maduinos/macroKey/docs/HARDWARE.md

> 만든 사람: maduinos<br>
> 문서 만든 날짜: 2026-08-03<br>
> https://maduinos.blogspot.com/

# macroKey 하드웨어

보드와 무관한 설계입니다. **핀 맵, 배선, 플래싱은 보드마다 다르므로 각 보드 문서에**
있습니다 — [지원 보드 목록](BOARDS.md)에서 고르세요.

전원은 어느 보드든 PC USB 하나뿐이고, 이 문서의 내용은 그 제약에서 나옵니다.

## 전력 예산

USB 2.0 장치는 500 mA를 넘게 쓸 수 없습니다. WS2812B 하나는 흰색 최대에서 채널당 약
20 mA, 즉 **60 mA**를 씁니다.

| 조건 | 전류 | 판정 |
| --- | --- | --- |
| 픽셀 1개 흰색 100% + MCU | 90 mA | 예산의 18%. 안전 |
| 픽셀 1개 단색 25% + MCU (기본값) | 35 mA | 예산의 7%. 넉넉 |

픽셀이 하나뿐이라 전력은 사실상 걱정거리가 아닙니다. 밝기를 100%로 올려도 안전합니다.
`Config.h`의 `MK_LED_MAX_MILLIAMPS`는 100으로 잡혀 있지만 1픽셀이 60 mA를 넘길 수 없어
실제로는 걸리지 않습니다. 그래도 남겨 둔 이유는 나중에 `MK_LED_COUNT`를 올리는 순간
다른 곳을 고치지 않아도 이 한 줄이 바로 안전장치로 동작하기 때문입니다.

DIN 라인의 **330~470 Ω 직렬 저항**과 VCC–GND 사이 **100 µF 전해 커패시터**는 모든 보드에서
같습니다.

> **1000 µF를 쓰지 마세요.** 흔히 보이는 그 값은 긴 스트립에 전용 어댑터를 다는 경우의
> 권장값입니다. 이 프로젝트는 픽셀 1개를 PC USB로만 급전하고, USB 2.0 규격은 장치의 벌크
> 커패시턴스를 10 µF로 제한합니다. 실제 포트는 수백 µF까지 견디지만 큰 용량은 돌입 전류로
> 포트 보호를 걸어 "USB 장치를 인식할 수 없음"이 되는 원인이 됩니다. 픽셀 1개에는 100 µF면
> 충분합니다.

**케이블이 조용한 원인입니다.** 길고 얇은 충전 전용 케이블(28 AWG, 2 m 이상)은 보드 쪽 전압을
4.6 V 근처까지 끌어내려 LED 색이 틀어지거나 MCU가 브라운아웃으로 리셋되게 만듭니다.
1 m 이하 데이터용 케이블을 쓰세요.

## WS2812B와 USB 타이밍

WS2812B는 비트뱅 프로토콜이라 전송 중 인터럽트를 막습니다. 픽셀 하나 갱신은 약 30 µs이고
USB SOF 주기는 1 ms이므로 여유가 충분합니다. 8픽셀 스트립일 때 걱정하던 USB 열거 불안정
문제는 픽셀 1개에서는 발생하지 않습니다. `MK_LED_FPS`(기본 50 Hz)는 그대로 두면 됩니다.

## 픽셀 1개로 무엇을 보여주는가

LED 합성 우선순위(높은 것이 이김):

1. 키/매크로 큐 — 탭 흰색, 빈 슬롯 어두운 빨강, 매크로 완료 초록
2. 매크로 실행 중 — 시안 펄스
3. 호스트 오버레이 — 설정 앱이 녹음 중 칠하는 빨강/분홍 등
4. 기본 씬 — 프로필 바탕색

8픽셀 설계에서 두 가지가 줄어듭니다.

- **키별 위치 표시가 불가능합니다.** 펌웨어는 모든 키의 누름을 이 하나의 픽셀로 모읍니다.
- AgentPet 상시 상태 LED는 없습니다(앱이 상시 실행되지 않음).

스트립으로 바꾸고 싶어지면 `Config.h`의 `MK_LED_COUNT`와 호스트 `config/model.py`의
`LED_COUNT`를 같은 값으로 올리면 됩니다. 팔레트 크기와 전류 제한은 그 값에서 자동으로
따라옵니다. `MK_LED_COUNT`와 `MK_KEY_COUNT`는 보드 속성이 아니라 제품 속성이라 `Config.h`에
있습니다 — 보드를 바꿔도 키패드는 8키 1픽셀입니다.

## 부팅 안전장치

펌웨어는 부팅 후 `MK_BOOT_GRACE_MS`(기본 2000 ms) 동안 HID 입력을 보내지 않습니다.
매크로가 잘못 설정돼 무한히 키를 뿜는 상태가 되면 이 2초가 재플래싱할 유일한 기회입니다.

그 2초 안에 부트로더로 들어가는 방법은 보드마다 다릅니다. **어느 보드든 그 방법을 미리
확인해 두세요** — 잘못된 펌웨어에서 빠져나오는 유일한 길이고, 필요해지는 시점에는 이미
키보드가 폭주하고 있습니다. Pro Micro는 `RST`–`GND` 더블탭, RP2040은 BOOTSEL이고, 각 보드
문서에 적혀 있습니다.

정상적인 첫 설치와 헷갈리지 마세요. 그쪽은 Pro Micro가 손댈 것이 없고 RP2040만 첫 1회
BOOTSEL이 필요합니다([BOARDS.md](BOARDS.md#펌웨어-설치)). 여기 적은 것은 **앱이 말을 걸
상대를 잃었을 때**의 탈출구입니다.

## 저장소

프로필이 사는 곳은 보드 속성입니다. 두 종류가 있고, 차이는 물릴 때까지 보이지 않습니다.

- **메모리 맵드 EEPROM** (AVR) — 읽기가 첫 명령부터 되고 쓰기가 그 자리에서 남습니다.
  `begin()`/`commit()`은 할 일이 없습니다.
- **플래시 에뮬레이션** (RP2040 등) — `begin()`이 채워야 첫 읽기가 유효하고, `commit()`이
  되써야 남습니다. 둘 중 하나를 빠뜨리면 패드가 쓰레기를 읽거나 뽑는 순간 다 잊는데,
  **어디에서도 실패하지 않습니다.**

`Profile`은 오직 `Storage.h`의 네 함수만 부르므로, 이 차이는 보드 헤더의
`MK_STORAGE_FLASH_EMULATED` 한 줄이 전부입니다.
