maduinos/macroKey/docs/PROTOCOL.md

> 만든 사람: maduinos<br>
> 문서 만든 날짜: 2026-08-03<br>
> https://maduinos.blogspot.com/

# macroKey 시리얼 프로토콜 v1

호스트 앱과 펌웨어가 USB CDC 위에서 주고받는 규격입니다. 설계 배경은
[`ARCHITECTURE.md`](ARCHITECTURE.md)를 참고하세요.

## 1. 링크

| 항목 | 값 |
| --- | --- |
| 전송 | USB CDC (ATmega32u4 native USB, `Serial`) |
| 속도 | 115200 8N1 (CDC라 실제 보율은 무시되지만 관례로 맞춥니다) |
| 인코딩 | ASCII |
| 프레이밍 | 한 줄에 메시지 하나, `\n` 종료 (`\r`은 무시) |
| 최대 줄 길이 | 96 바이트 (초과분은 버리고 `ERR code=long` 응답) |
| 프로토콜 버전 | `1` |

HID 입력과 시리얼은 완전히 독립입니다. 시리얼을 아무도 열지 않아도 키패드는 동작합니다.

## 2. 메시지 문법

```
<VERB> [key=value ...]
```

- `VERB`는 대문자, 키는 소문자입니다.
- 값에는 공백이 없습니다. 문자열이 필요하면 base64 또는 hex로 보냅니다.
- 알 수 없는 키는 무시합니다(전방 호환). 알 수 없는 `VERB`는 `ERR code=verb`입니다.
- 요청에 `id=N`(1~65535)을 붙이면 응답에 같은 `id`가 실립니다. 붙이지 않으면 응답도
  `id` 없이 옵니다.

## 3. 장치 → 호스트

### `HELLO` — 장치 소개

부팅 직후 한 번, 그리고 `IDENT` 요청마다 보냅니다.

```
HELLO proto=1 fw=0.9.0 board=promicro keys=8 leds=1 bytes=1024
HELLO proto=1 fw=0.9.0 board=promicro-rp2040 keys=8 leds=1 bytes=65520
HELLO proto=1 fw=0.9.1 board=promicro keys=8 leds=1 bytes=1024 reset=1
```

`reset=1`은 **부팅할 때 저장된 프로필을 읽지 못해 공장 기본값을 덮어썼다**는 뜻입니다.
값이 없으면 아니라는 뜻이며, 이 키를 모르는 구형 호스트는 규칙대로 무시합니다.

이 사실은 원래 부팅 직후 `LOG` 한 줄로만 나갔습니다. 그런데 호스트는 포트를 열고
보드가 안정되기를 기다린 뒤 그동안 도착한 것을 **버리고** `IDENT`를 보냅니다. 부팅에
한 번만 나가는 것은 그래서 아무도 보지 못합니다. `HELLO`는 `IDENT`마다 다시 나가므로,
플래그를 여기에 실어야 패드가 기억을 잃은 사실이 호스트에 도달합니다.

호스트는 `proto`가 자신이 아는 버전보다 크면 연결을 거부하고 사용자에게 앱 업데이트를
안내합니다. 조용히 계속 진행하지 않습니다.

### `EV` — 입력 이벤트

```
EV t=key    k=<0..7> g=<tap|double|hold|holdend> ms=<millis>
EV t=record k=<0..7> g=<tap|double> ms=<millis>
```

- `t=key`는 **알림용**입니다. 장치는 이미 HID를 보냈고, 설정 앱은 로깅에 씁니다.
  앱이 안 듣고 있어도 문제 없습니다.
- `t=host`는 **퇴역**입니다(구형 펌웨어가 보낼 수 있음). 설정 앱은 무시합니다.
- `t=record`는 **키 하나를 3초(`MK_RECORD_HOLD_MS`) 동안 단독으로 눌렀다**는 보고입니다.
  이것이 녹음의 유일한 진입점입니다.

  `g`는 **어느 슬롯을 프로그래밍하는지**입니다. 그냥 홀드하면 `tap`, 직전 릴리즈로부터
  `MK_DOUBLE_TAP_MS` 안에 다시 눌러 홀드하면(= 더블클릭 후 홀드) `double`입니다. 이
  판정은 릴리즈와 다음 프레스 사이의 간격만 보고 하며, 탭 지연(`PH_PENDING_TAP`)과는
  무관합니다 — 그쪽은 *이미 더블 바인딩이 있는 키*에서만 켜지는데, 녹음이 필요한 건
  정확히 더블 슬롯이 비어 있는 키이기 때문입니다. 지연 비용도 없습니다.

  `g`가 없는 구형 펌웨어는 `tap`으로 읽습니다.

  장치는 녹음 상태를 **전혀 갖지 않습니다.** 이 이벤트가 녹음 시작인지 종료인지는 설정
  앱이 정합니다. 양쪽이 상태를 나눠 가지면 재연결 후 서로 다른 모드에 있다고 믿게 되고,
  그건 픽셀은 빨간데 아무것도 캡처되지 않는(혹은 그 반대의) 설명 불가능한 고장이 됩니다.

  이벤트를 보내기 직전 장치는 그 키를 릴리즈까지 억제합니다. 손을 뗄 때 바인딩이 같이
  실행되지 않게 하기 위함입니다 — 키를 *쓰는* 게 아니라 *프로그래밍하는* 중이니까요.

  3초에 이르는 도중 400 ms 지점에서 `g=hold`가 한 번 나갑니다. 그래서 hold 제스처에는
  아무것도 바인딩할 수 없습니다. 앱은 이 이벤트를 시리얼 리더 스레드가 아닌 별도
  워커에서 처리해야 합니다.

### `STATE` — 현재 상태

```
STATE bright=64 ledmode=host hid=1 up=123456
```

### `OK` / `ERR`

```
OK  id=7
ERR id=7 code=<verb|arg|range|crc|long|busy|nomem|unsupported>
```

### `LOG` — 진단

```
LOG lvl=<d|i|w|e> msg=<base64>
```

기본은 꺼져 있고 `DBG on=1`로 켭니다. 정상 동작 중에는 시리얼을 조용하게 유지합니다.

## 4. 호스트 → 장치

### 연결 관리

| 메시지 | 설명 |
| --- | --- |
| `IDENT` | `HELLO`로 응답 |
| `PING` | `OK`로 응답. 링크 확인용 |
| `STATE?` | `STATE`로 응답. `macro=1`이면 매크로 재생 중 |
| `DBG on=<0\|1>` | `LOG` 출력 토글 |

매크로가 재생되는 동안에는 **`PING`·`IDENT`·`STATE?`만 답하고** 나머지 명령은
`ERR busy`로 거절합니다. 매크로는 `loop()` 안에서 EEPROM의 레코드를 읽으며 도는데, 그
도중에 프로필이 커밋되면 발밑에서 스텝이 바뀝니다. 반복 재생은 40분 넘게 이어질 수 있고
앱은 1초마다 링크를 확인하므로, 아무것도 답하지 않으면 그동안 패드가 뽑힌 것으로 보입니다
— 그래서 읽기만 열어 둡니다.

### LED

| 메시지 | 설명 |
| --- | --- |
| `LED mode=<host\|local>` | 앰비언트 계층 소유권. `host`는 3초 워치독이 걸립니다 |
| `LED bright=<0..255>` | 전역 밝기. 전력 상한 스케일링은 이 뒤에 적용됩니다 |
| `LED i=<0..leds-1> rgb=<RRGGBB> [fx=<효과>] [ms=<주기>]` | 픽셀 하나. 지금은 픽셀이 1개라 `i=0`뿐 |
| `LED all rgb=<RRGGBB> [fx=..] [ms=..]` | 전체 동일 색 |
| `LED frame=<RRGGBB,…leds개>` | 전체 프레임 한 번에. 애니메이션은 호스트가 계산 |
| `LED bar=<0..100> rgb=<RRGGBB>` | 진행률 바 (디버그/미리보기용) |

효과: `solid`, `breathe`, `pulse`, `blink`, `flash`, `rainbow`.

`frame=`은 호스트가 모든 픽셀을 직접 그리는 모드이고, `fx=`는 장치가 애니메이션을 돌리는
모드입니다. **효과를 장치에 맡기면 링크가 잠깐 끊겨도 애니메이션이 끊기지 않습니다.**
호스트 CPU를 아끼려면 `fx=`를, 복잡한 그라디언트가 필요하면 `frame=`을 쓰세요.

### 프로필 전송

프로필 블롭(AVR **1,024 B**, RP2040 **65,520 B**)을 base64 청크로 나눠 보냅니다.
`HELLO bytes=`가 해당 장치의 크기이며, 호스트는 다른 크기를 잘라 보내지 않고 거부합니다.
한 줄 96바이트 제한 때문에 청크당 페이로드는 48바이트(base64 64자)입니다.

```
호스트: PROF begin bytes=<HELLO의 bytes> crc=<CRC16 hex>
장치:   OK
호스트: PROF data seq=0 b64=<64자>
장치:   OK
        …  (seq 21까지)
호스트: PROF commit
장치:   OK              # CRC 검증 통과, EEPROM 기록 완료
        ERR code=crc    # 검증 실패, EEPROM은 그대로
```

**CRC가 맞을 때까지 EEPROM을 건드리지 않습니다.** 전송 중 케이블이 빠져도 장치에 남아 있던
프로필은 멀쩡합니다. `PROF begin` 후 5초 안에 `commit`이 없으면 스테이징 버퍼를 버립니다.

읽기는 반대 방향입니다.

```
호스트: PROF read
장치:   PROF begin bytes=<HELLO의 bytes> crc=<hex>
        PROF data seq=0 b64=<…>
        …
        PROF end
```

### 기타

| 메시지 | 설명 |
| --- | --- |
| `SAVE` | 런타임 변경(밝기 등)을 영구 저장소에 반영 |
| `RESET defaults=1` | 공장 초기화 |
| `BOOT` | 부트로더 진입 (펌웨어 업데이트용). 진입 방법이 없는 빌드는 `ERR code=unsupported` |
| `MOUSE home` | 포인터를 화면 좌상단으로 보냅니다. `Fixed screen` 녹화가 캡처 직전에 부릅니다 — 이후 모든 좌표를 그 모서리 기준으로 재므로 재생이 녹화한 자리에 떨어집니다. 부팅 유예 중이면 `ERR code=busy` |

## 5. 연결 수립 절차

호스트가 지켜야 하는 순서입니다.

1. 후보 시리얼 포트를 찾습니다 (VID/PID 또는 사용자 지정).
2. 포트를 열고 **2초 대기**합니다. Leonardo는 포트 열 때 리셋될 수 있습니다.
3. `IDENT`를 보내고 2초 안에 `HELLO`를 기다립니다. 없으면 다음 후보로 넘어갑니다.
4. `proto` 버전을 확인합니다.
5. `PROF read`로 장치 프로필을 읽어 로컬 프로필과 비교합니다. 다르면 사용자에게
   어느 쪽을 기준으로 할지 묻습니다. **말없이 덮어쓰지 않습니다.**
6. 녹음/미리보기 중에만 `LED mode=host`로 짧은 오버레이를 잡습니다. 평소에는
   앱을 종료해도 됩니다 — 패드는 HID로 혼자 동작합니다.

연결이 끊기면 지수 백오프(1s → 2s → 4s → 최대 30s)로 3번 절차부터 재시도합니다.
**한 번이라도 맺어졌던 링크에 한해서**입니다. 앱을 켤 때 패드가 없었던 경우까지 타이머로
계속 재시도하면 무관한 시리얼 장치의 포트를 반복해서 여는 셈이 되고, 포트를 여는 것만으로
리셋되는 보드가 흔합니다. 사용자가 직접 Disconnect한 경우도 재시도하지 않습니다.

## 6. 버전 정책

- 필드 **추가**는 마이너 변경입니다. 수신자는 모르는 키를 무시해야 합니다.
- 필드 **삭제**나 의미 변경, `VERB` 삭제는 `proto` 증가입니다.
- 장치는 자신이 아는 유일한 버전만 말합니다. 호환 계층을 장치에 넣지 않습니다.
  2 KB SRAM은 하위 호환 코드를 둘 자리가 아니고, 그 일은 호스트가 합니다.
