maduinos/macroKey/CLA.md

> 만든 사람: maduinos<br>
> 문서 만든 날짜: 2026-09-13<br>
> https://maduinos.blogspot.com/

# Contributor License Agreement

macroKey에 코드·문서·그 밖의 자료를 보내려면 이 문서에 한 번 동의해야 합니다.
PR을 열면 봇이 서명 방법을 알려 주고, 한 번 서명하면 이후 PR에는 다시 묻지 않습니다.

## 왜 필요한가

**기여한 코드의 저작권은 기여자에게 있습니다.** 그래서 프로젝트 소유자라도 그 코드를
현재 라이선스가 아닌 조건으로는 쓸 수 없습니다. macroKey는 하드웨어와 함께 판매될
예정이고, 나중에 라이선스를 바꾸거나 상업 라이선스를 따로 제공해야 할 수 있습니다.
기여자가 한 명이라도 그 권한을 주지 않았으면 그때 가서는 불가능합니다 — **소급해서
받을 수 없기 때문에** 지금 걸어 둡니다.

이 문서는 **저작권 양도가 아닙니다.** 기여자는 자기 코드의 저작권을 그대로 갖고,
아래 범위의 사용 허락만 추가로 줍니다.

---

## 동의 내용

이 저장소에 기여물(Contribution)을 제출함으로써 기여자는 다음에 동의합니다.

1. **저작권 라이선스.** 기여자는 maduinos에게 기여물을 복제·수정·2차적저작물 작성·
   공중송신·배포·재실시허락할 수 있는, **기간과 지역의 제한이 없고, 비독점적이며,
   무상이고, 취소할 수 없는** 라이선스를 부여합니다. 여기에는 **현재 저장소의
   라이선스가 아닌 조건 — 상업용·비공개 조건을 포함하여 — 으로 배포하는 것**이
   포함됩니다.

2. **특허 라이선스.** 기여물 자체 또는 기여물과 이 프로젝트의 결합에 의해 필연적으로
   침해되는, 기여자가 보유하거나 통제하는 특허청구항에 대하여, 위와 같은 범위의
   무상·취소불가 라이선스를 부여합니다.

3. **권리 보유의 진술.** 기여자는 기여물이 자신의 창작물이며 이 문서에 따른 라이선스를
   부여할 권한이 있음을 진술합니다. 기여물의 전부 또는 일부가 **고용주에게 귀속되는
   경우, 기여자는 고용주로부터 허락을 받았거나 고용주가 그 부분에 대한 권리를
   포기하였음**을 진술합니다.

4. **제3자 저작물.** 기여자가 자신의 창작물이 아닌 부분을 포함시키는 경우, 그 출처와
   라이선스를 기여물 안에 명시해야 합니다.

5. **저작권 유지.** 기여자는 기여물에 대한 자신의 저작권을 그대로 보유하며, 기여물을
   다른 곳에 다른 조건으로 사용·배포할 자유도 그대로 유지합니다.

6. **채택 의무 없음.** maduinos는 기여물을 반드시 반영할 의무가 없습니다.

7. **보증 없음.** 기여물은 있는 그대로 제공되며, 기여자는 관련 법이 요구하지 않는 한
   어떠한 보증도 하지 않습니다.

---

## English

By submitting a Contribution to this repository, you agree that:

1. **Copyright licence.** You grant maduinos a perpetual, worldwide, non-exclusive,
   royalty-free, irrevocable licence to reproduce, modify, prepare derivative works
   of, publicly display, sublicense and distribute your Contribution, **including
   under licence terms other than those of this repository at the time of the
   Contribution — commercial and proprietary terms included**.
2. **Patent licence.** You grant a licence of the same scope under any patent claims
   you own or control that are necessarily infringed by your Contribution alone or
   by its combination with this project.
3. **Right to grant.** The Contribution is your original work and you are legally
   entitled to grant the above. If any part of it belongs to your employer, you have
   their permission, or they have waived their rights in that part.
4. **Third-party material.** Anything in the Contribution that is not your own work
   is identified as such, with its source and licence, inside the Contribution.
5. **You keep your copyright.** This is a licence, not an assignment. You remain free
   to use and distribute your Contribution elsewhere on any terms you like.
6. **No obligation to use.** maduinos is under no obligation to merge or ship it.
7. **No warranty.** Contributions are provided as-is, without warranty of any kind
   except as required by applicable law.

The Korean text above and this English text describe the same agreement. If they
conflict, the Korean text governs.

---

## 서명하는 법

PR을 열면 봇이 댓글로 안내합니다. 그 PR에 아래 문장을 **그대로** 댓글로 남기면
서명됩니다.

```
I have read the CLA Document and I hereby sign the CLA
```

서명 기록은 이 저장소의 `cla-signatures` 브랜치에 남습니다. 문서가 개정되면 다시
서명을 요청합니다.

이 문서는 법률 자문이 아닙니다. 문의: https://maduinos.blogspot.com/
