maduinos/macroKey/tools/pyinstaller_hooks/README.md

> 만든 사람: maduinos<br>
> 문서 만든 날짜: 2026-08-12<br>
> https://maduinos.blogspot.com/

# Optional PyInstaller hooks (picked up by build_release.sh when present).
