maduinos/macroKey/firmware/firmware.ino

// macroKey firmware -- Arduino Leonardo / Micro / Pro Micro.
//
// Eight GPIO buttons and a WS2812 pixel presented as a USB HID keyboard and
// mouse. The pad is fully usable with no software installed; the desktop app
// is only for configuration and recording.
//
// docs/ARCHITECTURE.md  design and rationale
// docs/PROTOCOL.md      serial wire format
// docs/HARDWARE.md      pinout and power budget

#include "src/ButtonInput.h"
#include "src/Config.h"
#include "src/KeyEngine.h"
#include "src/LedController.h"
#include "src/Profile.h"
#include "src/SerialProtocol.h"

// Overrides the core's weak default so the HID endpoint is polled as often as
// the board allows. It has to be a definition in the sketch, not a header: the
// linker picks it over the weak one, and a header included twice would be two
// definitions of the same symbol.
#if defined(MK_HID_POLL_INTERVAL_IS_OVERRIDABLE)
int usb_hid_poll_interval = MK_HID_POLL_INTERVAL_MS;
#endif

static Profile gProfile;
static ButtonInput gInput;
static LedController gLeds;
static KeyEngine gEngine;
static SerialProtocol gSerial;

static uint32_t gLastScanAt = 0;

// RX and TX sit on PB0 and PD5, wired from VCC through a resistor down to the
// pin, so the pin lights them by sinking current. USB_Send() turns them on for
// 100 ms on every transfer -- HID reports included, which is why a keypress
// blinks them -- and it does so from the USB interrupt, where nothing can be
// hooked. Driving them off again just races that ISR and still leaves a flicker.
//
// Making the pins inputs with the pull-up off removes the sink entirely: there
// is no path for current, so the core can write the port all it likes and the
// LEDs cannot light. It has to run every pass rather than once in setup()
// because a USB reset re-runs TX_RX_LED_INIT and makes them outputs again.
#if MK_QUIET_BOARD_LEDS && defined(RXLED0) && defined(TXLED0)
static inline void quietBoardLeds() {
  DDRB &= (uint8_t) ~(1 << 0);
  PORTB &= (uint8_t) ~(1 << 0);
  DDRD &= (uint8_t) ~(1 << 5);
  PORTD &= (uint8_t) ~(1 << 5);
}
#else
static inline void quietBoardLeds() {}
#endif

// KeyEngine reports through plain function pointers so it carries no dependency
// on the serial layer. These trampolines are the only place the two meet.
static void reportKey(uint8_t key, uint8_t gesture, bool released) {
  gSerial.sendKeyEvent(key, gesture, released);
}

static void reportRecordRequest(uint8_t key, uint8_t gesture) {
  gSerial.sendRecordRequest(key, gesture);
}

// Called from inside a replaying macro, which blocks loop(). The engine
// services the button scanner itself; this is the lights and the link.
//
// Serial used to be left queued here, because a profile committed mid-macro
// would change the steps out from under it. A looped macro made that too
// expensive: 255 passes can run for the better part of an hour and the app
// polls the link every second, so the pad read as unplugged for the whole
// loop. SerialProtocol refuses anything that writes while a macro is on the
// stack instead, which keeps that guarantee and still answers a status query.
static void macroYield() {
  quietBoardLeds();
  gSerial.update(millis());
  gLeds.update(millis());
}

void setup() {
  quietBoardLeds();
  gInput.begin();

  bool profileValid = gProfile.begin();
  gLeds.begin(&gProfile);
  gEngine.begin(&gProfile, &gInput, &gLeds);
  gEngine.setReportCallback(reportKey);
  gEngine.setRecordCallback(reportRecordRequest);
  gEngine.setMacroYield(macroYield);
  gSerial.begin(&gProfile, &gEngine, &gLeds);
  // Latched, not just logged: the LOG below lands in the window the host
  // flushes on connect, so without this the pad losing its profile is silent.
  gSerial.setProfileReset(!profileValid);

  // Announce ourselves unconditionally: a host that opens the port later will
  // send IDENT, and one that was already listening gets the greeting for free.
  gSerial.sendHello();
  if (!profileValid) gSerial.sendLog('w', "profile reset to defaults");
}

void loop() {
  uint32_t now = millis();

  quietBoardLeds();

  if (now - gLastScanAt >= MK_SCAN_INTERVAL_MS) {
    gLastScanAt = now;
    gInput.update(now);
    gEngine.update(now);
  }

  gSerial.update(now);

  // LEDs go last. The WS2812 bit-bang blocks interrupts, so it stays off the
  // path between a key press and its HID report.
  gLeds.update(now);
}
