maduinos/macroKey/macrokey/app.py

"""Wires the pieces together. No UI toolkit is imported from here.

Everything the GUI can do, this class can do headless: connect, sync, record.
The GUI is a view over this object. After configuration the app can quit -- the
pad runs as a USB HID device on its own.
"""

from __future__ import annotations

import logging
import queue
import threading
from collections.abc import Callable
from dataclasses import replace

from .boards import DEFAULT_BOARD, Board, board_by_id, board_by_profile_size
from .config import (
    KEY_COUNT,
    Profile,
    ProfileError,
    Settings,
    binary,
    is_factory_default,
    load_profile,
    save_profile,
)
from .device import (
    DeviceClient,
    DeviceError,
    KeyEvent,
    RecordRequest,
    candidates,
)
from .recorder import Recorder
from .recorder.normalize import compile_device_macro, redact_secrets

log = logging.getLogger(__name__)

StatusCallback = Callable[[str], None]
EventCallback = Callable[[object], None]

#: How long the pad acknowledges a write for. Long enough to catch the eye
#: while looking at the keypad, short enough not to sit there.
CONFIRM_FLASH_MS = 600


class MacroKeyApp:
    def __init__(self, status: StatusCallback | None = None) -> None:
        self.settings = Settings.load()
        self.profile: Profile = load_profile()
        self._status_callbacks: list[StatusCallback] = []
        self._event_callbacks: list[EventCallback] = []
        if status is not None:
            self._status_callbacks.append(status)

        self.device = DeviceClient(
            on_event=self._on_device_event,
            on_status=self.status,
            on_disconnect=self._on_device_disconnect,
            on_connect=self._on_device_connect,
        )
        self.recorder = Recorder(
            min_gap_ms=self.settings.recorder_min_gap_ms,
            capture_mouse=self.settings.recorder_capture_mouse,
            anchor_mouse=self.settings.recorder_anchor_mouse,
            preserve_key_timing=self.settings.recorder_preserve_key_timing,
        )
        #: How many steps the last recording lost to the password filter.
        self.last_redacted = 0
        #: Set by whoever wants to drive hold-to-record; None disables it.
        self.session = None

        # Record requests are handled here, one at a time, and never on the
        # thread that delivered them. See `_record_worker`.
        self._record_queue: queue.Queue[tuple[int, str, bool] | None] = queue.Queue()
        self._record_thread: threading.Thread | None = None
        self._closed = threading.Event()

    # ------------------------------------------------------------ observers --

    def on_status(self, callback: StatusCallback) -> None:
        self._status_callbacks.append(callback)

    def on_event(self, callback: EventCallback) -> None:
        self._event_callbacks.append(callback)

    def status(self, message: str) -> None:
        log.info("%s", message)
        for callback in list(self._status_callbacks):
            try:
                callback(message)
            except Exception:  # noqa: BLE001 - a broken view must not stop the app
                log.exception("status callback raised")

    # ------------------------------------------------------------- lifecycle --

    def connect(self, port: str | None = None) -> None:
        """Opens the keypad, falling back to discovery when a named port is gone.

        The port number changes whenever the board re-enumerates, which happens
        on every firmware upload, so a remembered port goes stale routinely.
        Failing on that instead of looking again would mean the app cannot find
        a device that is plugged in and working.
        """
        closed = getattr(self, "_closed", None)
        if closed is not None and closed.is_set():
            raise DeviceError("application is closed")
        # `None` means "use the remembered choice"; an explicit empty string
        # means Auto. Treating both as falsy made selecting Auto silently reopen
        # the previously pinned port.
        remembered = port is None
        wanted = self.settings.port if remembered else port
        if remembered and wanted and wanted not in {item.device for item in candidates()}:
            self.status(f"{wanted} is gone; looking for the keypad")
            wanted = ""
        self.device.connect(wanted)
        # Closing and a worker finishing IDENT can cross by a few instructions.
        # Never let that late success resurrect a serial link after shutdown.
        if closed is not None and closed.is_set():
            self.device.disconnect()
            raise DeviceError("application closed while connecting")

    def disconnect(self) -> None:
        session = self.session
        try:
            if session is not None and getattr(session, "recording", False):
                session.abort("Keypad disconnected, so the recording was dropped")
        finally:
            # Releasing a recorder backend can fail independently of the serial
            # port. A failed cleanup must not leave the keypad attached while
            # the application reports that it disconnected.
            self.device.disconnect()

    def close(self) -> None:
        if self._closed.is_set():
            return
        self._closed.set()
        session = self.session
        if session is not None and getattr(session, "recording", False):
            try:
                session.abort("Application closed; recording discarded")
            except Exception:  # noqa: BLE001 - shutdown must continue
                log.exception("could not abort recording while closing")
        elif self.recorder.recording:
            self.recorder.stop()
        self.disconnect()
        self._record_queue.put(None)
        thread, self._record_thread = self._record_thread, None
        if thread is not None and thread is not threading.current_thread():
            thread.join(timeout=1.0)

    # ---------------------------------------------------------------- events --

    def _on_device_event(self, event: object) -> None:
        if isinstance(event, KeyEvent):
            # Tell the recorder so it drops the keypad's own HID echo.
            self.recorder.note_device_key()
        elif isinstance(event, RecordRequest):
            # A malformed or out-of-sync device must not be able to turn on
            # global input capture. Profile access validates the index again,
            # but recording starts well before a profile is touched.
            if not 0 <= event.key < KEY_COUNT:
                self.status(f"Ignored record request for invalid key {event.key}")
            elif self.session is None:
                self.status(
                    f"Key {event.key + 1} asked to record, but this app is not "
                    "listening — open the editor (macrokey) to program the pad"
                )
                # Distinct from recording-red: the pad asked, nobody answered.
                try:
                    self.device.set_led_mode(True, timeout_ms=900)
                    self.device.set_all((255, 140, 0), effect="flash", period=900)
                except DeviceError:
                    pass
            else:
                # Not inline. This callback *is* the serial reader thread, and
                # handling a record request means talking to the device: setting
                # the LED, then writing the whole profile. Every one of those
                # waits for a reply only the reader thread can deliver -- so
                # running them here means waiting on ourselves.
                self._queue_record_request(event.key, event.gesture)

        for callback in list(self._event_callbacks):
            try:
                callback(event)
            except Exception:  # noqa: BLE001
                log.exception("event callback raised")

    def _on_device_disconnect(self, reason: str) -> None:
        """Stops global capture immediately when the only stop control vanishes."""
        session = self.session
        if session is not None and getattr(session, "recording", False):
            try:
                session.abort("Keypad disconnected, so the recording was dropped")
            except Exception:  # noqa: BLE001 - preserve the original link failure
                log.exception("could not abort recording after disconnect")

    def request_record(
        self, key: int, gesture: str = "tap", *, finish_only: bool = False
    ) -> None:
        """Asks the session to start or finish recording into `key`.

        Public because the session's own watchdog needs it: a recording that has
        run too long has to be finished, and that must happen on the worker like
        every other request rather than on whatever thread noticed.
        """
        self._queue_record_request(key, gesture, finish_only=finish_only)

    def _queue_record_request(
        self, key: int, gesture: str = "tap", *, finish_only: bool = False
    ) -> None:
        """Hands a record request to the worker, starting it on first use."""
        closed = getattr(self, "_closed", None)
        if closed is not None and closed.is_set():
            return
        if self._record_thread is None or not self._record_thread.is_alive():
            self._record_thread = threading.Thread(
                target=self._record_worker, name="macrokey-record", daemon=True
            )
            self._record_thread.start()
        self._record_queue.put((key, gesture, finish_only))

    def _record_worker(self) -> None:
        """Runs record requests in order, off the reader thread.

        One thread rather than one per request: start and finish are two halves
        of the same state machine, and handling them concurrently would let a
        finish overtake the start it belongs to.
        """
        while True:
            request = self._record_queue.get()
            if request is None:
                return
            key, gesture, finish_only = request
            closed = getattr(self, "_closed", None)
            if closed is not None and closed.is_set():
                continue
            session = self.session
            if session is None:
                continue
            if finish_only and (
                not getattr(session, "recording", False)
                or getattr(session, "active_key", None) != key
            ):
                # A watchdog timeout queued a finish, but disconnect/cancel won
                # the race. Treating the stale toggle as a fresh start would
                # briefly turn global capture back on with no keypad attached.
                continue
            try:
                session.handle_request(key, gesture)
            except Exception:  # noqa: BLE001 - a bad recording must not end the thread
                log.exception("record request for key %d failed", key + 1)
                self.status(f"Key {key + 1}: recording failed, see the log")

    # --------------------------------------------------------------- profile --

    @property
    def board(self) -> Board:
        """Which board the profile is being shaped for, connected or not.

        A live HELLO is the truth. Without one the last board seen is a far
        better guess than the registry default, because the alternative is to
        assume the smallest board on the list: that reports an RP2040's fill
        against a 308 record ceiling instead of 21801, and refuses recordings
        the pad has ample room for. It is only ever wrong across a board swap
        made while the app is closed, and the next connect corrects it.
        """
        hello = self.device.hello
        if hello is not None:
            found = board_by_id(hello.board) or board_by_profile_size(hello.profile_bytes)
            if found is not None:
                return found
        remembered = board_by_id(self.settings.last_board)
        return remembered if remembered is not None else DEFAULT_BOARD

    @property
    def profile_layout(self) -> binary.ProfileLayout:
        hello = self.device.hello
        # A connected pad states its own blob size; trust that over the board
        # table in case a firmware ships a size the registry has not caught up
        # with. Disconnected, the remembered board is all there is.
        if hello is not None and hello.profile_bytes in binary.SUPPORTED_PROFILE_SIZES:
            return binary.layout_for_size(hello.profile_bytes)
        return binary.layout_for_board(self.board)

    def _on_device_connect(self, hello) -> None:
        """Persists the connected board so the next cold start knows its size.

        Driven by the device client rather than by `connect` above: the CLI
        opens the pad through `app.device.connect` directly, and hanging this
        off one caller meant `macrokey info` talked to an RP2040 and the app
        still came back assuming the smallest board.
        """
        found = board_by_id(hello.board) or board_by_profile_size(hello.profile_bytes)
        if found is None or found.id == self.settings.last_board:
            return
        self.settings.last_board = found.id
        try:
            self.settings.save()
        except OSError:  # noqa: BLE001 - a read-only config dir must not fail a connect
            log.exception("could not remember the connected board")

    def save(self) -> None:
        save_profile(self.profile)
        self.status("Profile saved")

    def push_profile(self) -> None:
        """Writes the host profile to the device, then says so on the pad."""
        blob = binary.encode_profile(self.profile, profile_size=self.profile_layout.size)
        self.device.write_profile(blob)
        self.confirm_on_device()

    def confirm_on_device(self, color: tuple[int, int, int] = (0, 255, 60)) -> None:
        """Flashes the pixel to acknowledge a write.

        A message in a status bar is in the wrong place: the thing that changed
        is the keypad, and that is where the person is looking after pressing
        Write. Failing to flash is not a failure of the write, so it is swallowed.
        """
        try:
            # A short window, so a crash between here and the release cannot
            # leave the pad stuck on the confirmation colour.
            self.device.set_led_mode(True, timeout_ms=CONFIRM_FLASH_MS)
            self.device.set_all(color, effect="flash", period=CONFIRM_FLASH_MS)
        except DeviceError:
            pass

    def pull_profile(self) -> Profile:
        """Reads the device profile without adopting it."""
        return binary.decode_profile(self.device.read_profile())

    def device_matches_host(self) -> bool:
        """True when device and host hold the same profile bytes."""
        return self.compare_with_device()[0]

    def compare_with_device(self) -> tuple[bool, bool]:
        """``(profiles match, the pad is holding nothing)``, from one read.

        Both answers come from the same blob because they are asked together and
        a second read costs a round trip on a link that is already the slow part
        of connecting.

        The second answer is the one that matters: a pad that differs and a pad
        that has *forgotten* look identical to a byte comparison, and only one
        of them must never be copied over a computer that still has the macros.
        """
        try:
            blob = self.device.read_profile()
            matches = blob == binary.encode_profile(
                self.profile, profile_size=self.profile_layout.size
            )
            return matches, is_factory_default(binary.decode_profile(blob))
        except (DeviceError, ValueError):
            return False, False

    # -------------------------------------------------------------- recording --

    def start_recording(self, on_event=None) -> None:
        """`on_event` receives each raw event as it is captured.

        The editor shows them as they arrive: a recording that is capturing
        nothing looks identical to one that is working until it is stopped,
        which on Wayland is a common and confusing way to lose two minutes.
        """
        if self.recorder.recording:
            raise RuntimeError(
                "a recording is already in progress — finish it before starting another"
            )
        self.recorder._on_event = on_event
        self.recorder.start()
        self.status("Recording.")

    def stop_recording(self) -> list[dict]:
        events = self.recorder.stop()
        self.recorder._on_event = None
        steps = self.recorder.steps(events)
        # Before anything can look at it, let alone store it. Capture is
        # global, so a recording running while a sudo prompt was answered
        # holds that password verbatim -- which has already happened once.
        steps, self.last_redacted = redact_secrets(steps)
        if self.last_redacted:
            self.status(
                f"Dropped {self.last_redacted} step(s) that looked like a password"
            )
        self.status(f"Recorded {len(steps)} step(s)")
        return steps

    def _macro_capacity_used(self, *, ignore_slot: int | None = None) -> int:
        from .config.model import macro_records

        total = 0
        for index, existing in enumerate(self.profile.device_macros):
            if ignore_slot is not None and index == ignore_slot:
                continue
            if existing:
                total += macro_records(existing)
        return total

    def _find_macro_slot(
        self, macro: list, *, also_free: int | None = None
    ) -> int | None:
        """Index that can hold `macro`, or None. Does not mutate the profile.

        `also_free` is a slot that will be released when the binding that owns it
        is replaced -- counted as empty for capacity and reuse.
        """
        from .config.model import MACRO_SLOTS, macro_records

        macros = self.profile.device_macros
        needed = macro_records(macro)
        used = self._macro_capacity_used(ignore_slot=also_free)
        layout = getattr(self, "profile_layout", binary.DEFAULT_LAYOUT)
        if used + needed > layout.record_capacity:
            return None

        limit = max(len(macros), MACRO_SLOTS)
        for index in range(limit):
            if also_free is not None and index == also_free:
                return index
            if index >= len(macros) or not macros[index]:
                return index
        if len(macros) < MACRO_SLOTS:
            return len(macros)
        return None

    def set_repeat(self, key: int, gesture: str, repeat: int) -> str:
        """Makes this key's binding replay `repeat` times, wrapping a shortcut.

        A recording already has somewhere to put the count -- the keymap entry
        naming its slot. A shortcut does not: its four bytes are type, modifiers,
        keycode and flags, with nothing spare. So asking a shortcut to repeat
        turns it into a one-shortcut macro, which is what the pad can repeat.

        Going back to once unwraps it again, rather than leaving a slot holding
        a macro that exists only to be run a single time.

        Returns what happened, for the status line. Raises `ProfileError` when
        there is no room for the wrapping.
        """
        from .config.model import (
            MACRO_SLOTS,
            MIN_MACRO_REPEAT,
            Action,
            repeated_shortcut,
            wrap_shortcut,
        )

        current = self.profile.action(key, gesture)
        macros = self.profile.device_macros

        if current.kind == "sequence":
            held = macros[current.slot] if current.slot < len(macros) else []
            shortcut = repeated_shortcut(held)
            # A wrapped shortcut asked to run once is just the shortcut again.
            # Unwrapping returns the slot; `reclaim_storage` then empties it.
            if shortcut is not None and repeat <= MIN_MACRO_REPEAT:
                self.profile.set_action(key, gesture, shortcut)
                self.profile.reclaim_storage()
                return f"{shortcut.describe()}, once"
            self.profile.set_action(key, gesture, replace(current, repeat=repeat))
            return f"repeats {repeat} times"

        if current.kind != "key":
            raise ProfileError("only a shortcut or a recording can be repeated.")
        if repeat <= MIN_MACRO_REPEAT:
            return f"{current.describe()}, once"

        macro = wrap_shortcut(current)
        slot = self._find_macro_slot(macro)
        if slot is None:
            raise ProfileError(
                "the keypad's macro storage is full, and repeating a shortcut "
                "needs a macro slot. Clear a key you no longer use."
            )
        while len(macros) < MACRO_SLOTS:
            macros.append([])
        macros[slot] = macro
        self.profile.set_action(
            key, gesture, Action(kind="sequence", slot=slot, repeat=repeat)
        )
        self.profile.reclaim_storage()
        return f"{current.describe()} repeats {repeat} times"

    def recording_fits(self, steps: list[dict], key: int, gesture: str) -> bool:
        """True when `assign_recording` would succeed without changing the profile."""
        if self.recorder.device_action(steps) is not None:
            return True
        macro = self.recorder.device_macro(
            steps,
            anchor_pointer=getattr(self.recorder, "anchor_mouse", False),
            max_records=self.profile_layout.max_records_per_slot,
        )
        if macro is None:
            return False
        previous = self.profile.action(key, gesture)
        also_free = previous.slot if previous.kind == "sequence" else None
        return self._find_macro_slot(macro, also_free=also_free) is not None

    def assign_recording(
        self, steps: list[dict], key: int, gesture: str, name: str = ""
    ) -> str:
        """Stores a recording on the pad. Raises if it will not fit.

        The existing binding is left untouched until a device placement is known,
        so a rejected recording cannot wipe a working key.
        """
        from .config import Action
        from .config.model import MACRO_SLOTS

        device_action = self.recorder.device_action(steps)
        if device_action is not None:
            self.profile.set_action(key, gesture, device_action)
            freed = self.profile.reclaim_storage()
            if freed:
                log.debug("reclaimed %d macro slot(s)", freed)
            return f"on the keypad: {device_action.describe()}"

        # Not the None-returning wrapper: the two ways this fails ask for
        # different things from the person, and saying "shorten it" to someone
        # whose recording contains one key the pad cannot send sends them off
        # trimming a macro that was never too long.
        macro = compile_device_macro(
            steps,
            anchor_pointer=getattr(self.recorder, "anchor_mouse", False),
            max_records=self.profile_layout.max_records_per_slot,
        )
        previous = self.profile.action(key, gesture)
        also_free = previous.slot if previous.kind == "sequence" else None
        slot = self._find_macro_slot(macro, also_free=also_free)
        if slot is None:
            raise ProfileError(
                "the keypad's macro storage is full. Clear a key you no longer "
                "use, or record this one in shorter pieces."
            )

        macros = self.profile.device_macros
        while len(macros) < MACRO_SLOTS:
            macros.append([])
        while len(macros) <= slot:
            macros.append([])
        if also_free is not None and also_free != slot and also_free < len(macros):
            macros[also_free] = []
        macros[slot] = macro
        self.profile.set_action(key, gesture, Action(kind="sequence", slot=slot))
        freed = self.profile.reclaim_storage()
        if freed:
            log.debug("reclaimed %d macro slot(s)", freed)
        return f"on the keypad: {len(macro)} step macro"
