maduinos/macroKey/tests/test_firmware_agreement.py

"""The firmware and the host must agree about the same bytes, on every board.

`firmware/src/Profile.h` and `macrokey/config/binary.py` each carry their own
copy of the profile layout. Nothing checks them against each other at build time,
and a disagreement does not fail anywhere -- it produces a macro that replays
garbage, on a device with one pixel and no screen.

The layout check walks `macrokey.boards.BOARDS`, building the firmware once per
board with that board's `-D` and comparing what it reports against what the
registry says. A board added to the registry is therefore checked from the
moment it exists, and a board header that disagrees with its own registry entry
fails here rather than on the hardware.

So the firmware is compiled here for the PC, against the stub headers in
`firmware/test/stubs`, and fed bytes the host encoder produced. What the
firmware's own reader makes of them is compared with what went in.

Skipped, not failed, when there is no C++ compiler: this is a cross-language
check, and a machine without one can still run everything else.
"""

from __future__ import annotations

import shutil
import subprocess
import sys
from pathlib import Path

import pytest

from macrokey.boards import BOARDS, DEFAULT_BOARD, Board
from macrokey.config import binary, model
from macrokey.recorder.evdev_source import MOTION_SLICE_SECONDS
from macrokey.recorder.normalize import reduce_to_device_macro

ROOT = Path(__file__).resolve().parent.parent
FIRMWARE = ROOT / "firmware"
HARNESS = FIRMWARE / "test" / "harness.cpp"

COMPILER = shutil.which("g++") or shutil.which("clang++")
pytestmark = pytest.mark.skipif(
    COMPILER is None, reason="no C++ compiler, so the firmware cannot be run here"
)

#: Sources the harness needs. LedEffects comes along because LedController uses
#: it, and SerialProtocol because a command's effect on the device -- not merely
#: its reply -- is the thing worth testing.
SOURCES = ("Profile.cpp", "Util.cpp", "KeyEngine.cpp", "ButtonInput.cpp",
           "LedController.cpp", "LedEffects.cpp", "SerialProtocol.cpp", "Storage.cpp")


@pytest.fixture(scope="session")
def build_harness(tmp_path_factory):
    """Builds the firmware for this machine, once per board.

    The board is forced with its own `-D` rather than inferred, because this
    machine is neither an AVR nor an RP2040 and the header would otherwise have
    nothing to go on. The store is forced memory-mapped for the same reason:
    a flash-emulated board wants LittleFS, which is a core library and not
    something the stubs stand in for. Neither affects the layout, which is what
    this file compares.
    """
    directory = tmp_path_factory.mktemp("firmware")
    built: dict[str, Path] = {}

    def build(board: Board) -> Path:
        if board.id not in built:
            binary_path = directory / f"harness-{board.id}"
            command = [
                COMPILER, "-std=c++11", "-w", "-o", str(binary_path),
                f"-D{board.select_macro}",
                "-DMK_STORAGE_FLASH_EMULATED=0",
                "-I", str(FIRMWARE / "test" / "stubs"),
                "-I", str(FIRMWARE / "src"),
                str(HARNESS),
                *[str(FIRMWARE / "src" / name) for name in SOURCES],
            ]
            result = subprocess.run(command, capture_output=True, text=True)
            if result.returncode != 0:
                pytest.fail(
                    f"the firmware did not build for {board.id}:\n{result.stderr}"
                )
            built[board.id] = binary_path
        return built[board.id]

    return build


@pytest.fixture(scope="session")
def harness(build_harness) -> Path:
    """The default board, for everything that is not about board differences."""
    return build_harness(DEFAULT_BOARD)


def run(harness: Path, *args: str, blob: bytes | None = None) -> list[str]:
    result = subprocess.run(
        [str(harness), *args], input=blob, capture_output=True, timeout=60
    )
    assert result.returncode == 0, result.stderr.decode("utf-8", "replace")
    return result.stdout.decode("ascii", "replace").splitlines()


def fields(lines: list[str]) -> dict[str, int]:
    return {line.split()[0]: int(line.split()[1]) for line in lines if line}


def serial(harness: Path, blob: bytes, *commands: str) -> tuple[dict[str, int], list[str]]:
    """Runs `commands` against the real serial layer on a pad holding `blob`.

    Returns the device state either side of them, and the lines the pad sent
    back. State first because the reply is rarely the interesting part: the
    failures this catches are commands that answered `OK` and left the pad
    holding something stale.
    """
    lines = run(harness, "serial", "".join(f"{line}\n" for line in commands), blob=blob)
    cut = lines.index("--- transcript")
    return fields(lines[:cut]), lines[cut + 1 :]


def profile_transfer(blob: bytes) -> list[str]:
    """The host half of a profile write, as lines."""
    import base64

    crc = binary.blob_crc(blob)
    lines = [f"PROF begin bytes={len(blob)} crc={crc:04X}"]
    for sequence, offset in enumerate(range(0, len(blob), binary.CHUNK_BYTES)):
        payload = base64.b64encode(blob[offset : offset + binary.CHUNK_BYTES]).decode()
        lines.append(f"PROF data seq={sequence} b64={payload}")
    lines.append("PROF commit")
    return lines


# ------------------------------------------------------------------- layout --


@pytest.mark.parametrize("board", BOARDS, ids=[board.id for board in BOARDS])
def test_the_two_layouts_are_the_same_layout(build_harness, board: Board) -> None:
    """The check this whole file exists for, for every board in the registry.

    The regions before the macro index are the same on every board -- header,
    keymap and palette are counts, not storage -- so what actually varies here
    is the index width, the region that is left, and the schema that says which
    of the two an image is.
    """
    layout = binary.layout_for_board(board)
    seen = fields(run(build_harness(board), "layout"))
    assert seen == {
        "keymap_offset": binary.KEYMAP_OFFSET,
        "keymap_size": binary.KEYMAP_SIZE,
        "keymap_gestures": len(binary.KEYMAP_GESTURES),
        "palette_offset": binary.PALETTE_OFFSET,
        "macro_offset": binary.MACRO_OFFSET,
        "macro_index_size": layout.index_size,
        "macro_record_size": binary.RECORD_SIZE,
        "macro_record_capacity": layout.record_capacity,
        "macro_max_records": board.max_records_per_slot,
        # One byte of a keymap entry, so this is a ceiling neither side can
        # raise alone.
        "macro_max_loops": model.MAX_MACRO_REPEAT,
        "macro_slots": model.MACRO_SLOTS,
        "profile_size": board.profile_size,
        "schema": board.schema,
        "text_delay_default": FIRMWARE_TEXT_DELAY_MS,
        # What one move record represents. The firmware replays a move over
        # this long when nothing after it says otherwise, so if the recorder
        # ever slices motion differently the pad would replay every drag at the
        # wrong speed -- and pointer acceleration would turn that into landing
        # somewhere else.
        "move_slice_ms": int(MOTION_SLICE_SECONDS * 1000),
        # How often the host polls the HID endpoint, which is the ceiling on
        # how fast a replayed movement can be sent. arduino-pico defaults it to
        # 10 ms and the sketch overrides the core's weak symbol to get 1; the
        # AVR core is 1 already. At 10 a recorded 50 ms slice of motion took
        # half a second to replay -- the pointer landed in the right place, so
        # nothing failed and the only symptom was that mouse macros felt wrong
        # on that board. A board that cannot manage 1 ms is allowed, but it has
        # to say so, because runMoves divides by this.
        "hid_poll_interval_ms": 1,
    }


#: What the firmware was built with, and what a profile of 0 falls back to.
FIRMWARE_TEXT_DELAY_MS = 5


def test_the_pad_honours_the_typing_speed_from_the_profile(harness) -> None:
    """Replay is faster than the recording was -- consecutive characters merge
    into one run with no timing kept -- so this is the knob for anything that
    has to catch up. It lives on the profile because the pad replays with the
    app closed, and zero means whatever the firmware was built with."""
    profile = sample_profile()

    profile.text_speed_ms = 0
    lines = run(harness, "profile", blob=binary.encode_profile(profile))
    assert f"text_delay {FIRMWARE_TEXT_DELAY_MS}" in lines

    profile.text_speed_ms = 40
    lines = run(harness, "profile", blob=binary.encode_profile(profile))
    assert "text_delay 40" in lines


def test_the_typing_speed_does_not_disturb_the_body(harness) -> None:
    """It lives in a header byte that was reserved and written as zero, which is
    why it needed no schema bump. The CRC covers the body, not the header."""
    slow, quick = sample_profile(), sample_profile()
    slow.text_speed_ms = 200
    assert binary.encode_profile(slow)[16:] == binary.encode_profile(quick)[16:]
    assert run(harness, "profile", blob=binary.encode_profile(slow))[0] == "valid 1"


# ------------------------------------------------------------------ profile --


def sample_profile() -> model.Profile:
    profile = model.default_profile()
    profile.device_macros = [
        reduce_to_device_macro([
            {"type": "text", "params": {"text": "sudo apt update && sudo apt upgrade -y"}},
            {"type": "delay", "params": {"ms": 300}},
            {"type": "hotkey", "params": {"hotkey": "enter"}},
        ]),
        reduce_to_device_macro(
            [
                {"type": "mouse_button", "params": {"button": "left", "mode": "press"}},
                {"type": "mouse_move", "params": {"dx": 300, "dy": -200}},
                {"type": "mouse_button", "params": {"button": "left", "mode": "release"}},
            ],
            anchor_pointer=True,
        ),
    ]
    profile.set_action(0, "tap", model.Action(kind="sequence", slot=0))
    profile.set_action(1, "double", model.Action(kind="sequence", slot=1))
    return profile


def test_the_firmware_accepts_a_profile_the_host_built(harness) -> None:
    """Magic, schema, topology and CRC, checked by the firmware's own code."""
    lines = run(harness, "profile", blob=binary.encode_profile(sample_profile()))
    assert "valid 1" in lines


def test_the_keymap_reads_back_as_it_was_written(harness) -> None:
    profile = sample_profile()
    lines = run(harness, "profile", blob=binary.encode_profile(profile))

    seen = {}
    for line in lines:
        if not line.startswith("key "):
            continue
        _, key, gesture, type_id, a, b = line.split()
        seen[(int(key), gesture)] = (int(type_id), int(a), int(b))

    for key in range(model.KEY_COUNT):
        for gesture in model.GESTURES:
            action = profile.action(key, gesture)
            expected = action.encode()[:3] if not action.is_empty else (0, 0, 0)
            assert seen[(key, gesture)] == expected, f"key {key + 1} {gesture}"


def test_hold_reads_as_empty_because_it_has_no_slot(harness) -> None:
    """It is how recording starts, so it is reported but never stored."""
    lines = run(harness, "profile", blob=binary.encode_profile(sample_profile()))
    holds = [line for line in lines if line.startswith("key ") and " hold " in line]
    assert len(holds) == model.KEY_COUNT
    assert all(line.endswith(" 0 0 0") for line in holds)


def test_the_macro_records_read_back_byte_for_byte(harness) -> None:
    """Where an index and a region that disagreed would show up."""
    profile = sample_profile()
    lines = run(harness, "profile", blob=binary.encode_profile(profile))

    seen = {}
    for line in lines:
        if not line.startswith("macro "):
            continue
        parts = line.split()
        seen[int(parts[1])] = [tuple(int(n) for n in item.split(",")) for item in parts[2:]]

    for slot, macro in enumerate(profile.device_macros):
        expected = [record for action in macro for record in action.records()]
        assert seen[slot] == expected, f"slot {slot}"


# ------------------------------------------------------------------ buttons --


def test_which_slot_a_hold_programs(harness) -> None:
    seen = {line.split()[0]: line.split()[1] for line in run(harness, "buttons")}
    assert seen == {
        "hold": "tap",
        "tap_then_hold": "double",       # double-click, then keep holding
        "tap_pause_hold": "tap",         # too slow to be a pair
        "short_hold": "none",            # 500 ms is not a request
        # Re-recording a double macro goes through the tap-deferral path, which
        # is only armed once the slot is full -- a different branch entirely.
        "tap_then_hold_when_double_is_bound": "double",
        "hold_just_after_boot": "tap",   # releasedAt starts at zero
    }


def test_the_buttons_are_still_scanned_while_a_macro_replays(harness) -> None:
    """A macro blocks loop(). If the scan stops with it, the second press of a
    double-record gesture is timestamped after the macro finishes -- seconds
    past the pair window -- so recording into the double slot was impossible on
    any key that already had a macro to replay.

    Slot 0, because it types and pauses and so lasts long enough for a press to
    debounce. Slot 1 is a drag with no pause in it: over in a few milliseconds,
    which is both too short to register a press and too short to matter.
    """
    lines = run(harness, "replay", "0", blob=binary.encode_profile(sample_profile()))
    assert "scanned-during-replay 1" in lines


# ------------------------------------------------------------------- replay --


# --------------------------------------------------------------------- loops --


def typed_text(lines: list[str]) -> str:
    return "".join(chr(int(line.split()[1])) for line in lines if line.startswith("type "))


SAMPLE_TEXT = "sudo apt update && sudo apt upgrade -y"


def test_the_loop_ceiling_agrees_with_the_host(harness) -> None:
    """One byte in a keymap entry, described in two places."""
    assert fields(run(harness, "layout"))["macro_max_loops"] == model.MAX_MACRO_REPEAT


def test_a_loop_replays_the_macro_once_per_pass(harness) -> None:
    blob = binary.encode_profile(sample_profile())
    lines = run(harness, "replay", "0", "3", blob=blob)
    assert typed_text(lines) == SAMPLE_TEXT * 3


def test_a_binding_with_no_loop_count_runs_once(harness) -> None:
    """Zero is what every profile written before loop counts existed holds.

    It has to mean one pass rather than none, or upgrading the firmware would
    silently stop every macro already on the pad.
    """
    blob = binary.encode_profile(sample_profile())
    assert typed_text(run(harness, "replay", "0", "0", blob=blob)) == SAMPLE_TEXT


def test_each_pass_lets_go_of_what_it_was_holding(harness) -> None:
    """A recording may end mid-hold -- a press with no release is half a hold,
    and the normaliser keeps it. Looping that would press an already-pressed key
    and then leave it down when the loop stopped.
    """
    blob = binary.encode_profile(sample_profile())
    lines = run(harness, "replay", "1", "3", blob=blob)
    assert lines.count("key release-all") == 3


def test_a_key_pressed_during_a_loop_stops_it(harness) -> None:
    """The reason a ceiling of 255 is safe to offer at all: 255 passes of a
    recording with real hold timing in it is most of an hour, and the pad is a
    keyboard the whole time.
    """
    blob = binary.encode_profile(sample_profile())
    passes = typed_text(run(harness, "replay", "0", "20", "300", blob=blob))
    assert len(passes) < len(SAMPLE_TEXT) * 20, "the press did not stop the loop"


def test_the_key_that_stops_a_loop_does_not_also_fire(harness) -> None:
    """Stopping a macro is not using the key. Without the swallow, letting go
    of it fires its tap -- so stopping one macro starts another.
    """
    blob = binary.encode_profile(sample_profile())
    lines = run(harness, "replay", "0", "20", "300", blob=blob)
    assert "stop-key-suppressed 1" in lines


def test_a_key_held_before_the_loop_started_does_not_stop_it(harness) -> None:
    """The key the macro is running *for* is normally up by the time it runs --
    tap and double both fire on release -- but the scan is alive through a macro
    and the harness holds key 1 down throughout. Counting what was already held
    would stop every loop in its first pass.
    """
    blob = binary.encode_profile(sample_profile())
    assert typed_text(run(harness, "replay", "0", "2", blob=blob)) == SAMPLE_TEXT * 2


def test_a_press_inside_the_arming_window_does_not_stop_a_macro(harness) -> None:
    """A press this early is someone pressing the key again, not stopping it: it
    queues and fires afterwards, the way an ordinary macro has always behaved. A
    short macro that a second press killed would be one nobody could press twice
    in a row.
    """
    blob = binary.encode_profile(sample_profile())
    lines = run(harness, "replay", "0", "1", "300", blob=blob)
    assert typed_text(lines) == SAMPLE_TEXT
    assert "stop-key-suppressed 0" in lines


def test_a_long_single_pass_macro_can_still_be_stopped(harness) -> None:
    """The pass count is the wrong thing to gate stopping on, and this is the
    recording that proved it: 39 s of real hold timing bound to a key at one
    repeat could not be stopped by anything short of the cable. Arming on how
    long the run has lasted covers a loop and a long recording both.
    """
    profile = model.default_profile()
    profile.device_macros = [
        [
            model.Action(kind="delay", delay_ms=12000),
            model.Action(kind="key", hotkey="esc"),
        ]
    ]
    lines = run(harness, "replay", "0", "1", "2000", blob=binary.encode_profile(profile))
    # KEY_ESC is 0xB1 = 177 in Keyboard.h. The macro never reaches it.
    assert "key press 177" not in lines, "the press did not stop the macro"
    assert "stop-key-suppressed 1" in lines


def test_a_status_query_is_answered_from_inside_a_macro(harness) -> None:
    """Why serial is pumped from the macro yield at all. The app polls the link
    every second; a loop that answered nothing would read as an unplugged pad
    for as long as it ran.
    """
    blob = binary.encode_profile(sample_profile())
    lines = run(harness, "macro-serial", "0", "STATE?\n", blob=blob)
    state = next(line for line in lines if line.startswith("STATE "))
    assert "macro=1" in state, state


def test_a_profile_write_is_refused_from_inside_a_macro(harness) -> None:
    """The guarantee that kept serial out of the yield in the first place:
    committing a profile while runMacro is reading its records out of EEPROM
    would change the steps out from under it.
    """
    blob = binary.encode_profile(sample_profile())
    lines = run(harness, "macro-serial", "0", "PROF begin bytes=1024 crc=0000\n", blob=blob)
    assert any("ERR" in line and "busy" in line for line in lines), lines
    assert "macro_running_after 0" in lines


def test_the_firmware_reads_a_double_binding_repeat_too(harness) -> None:
    """Tap and double are separate keymap entries, and the count lives in the
    entry -- so the pad has to read it from whichever one fired. The sample
    binds slot 1 to key 2's double, which is the gesture that is easy to leave
    out of a keymap walk.
    """
    profile = sample_profile()
    profile.set_action(1, "double", model.Action(kind="sequence", slot=1, repeat=9))
    lines = run(harness, "profile", blob=binary.encode_profile(profile))

    entry = next(line for line in lines if line.startswith("key 1 double "))
    _, _, _, type_id, slot, repeat = entry.split()
    assert (int(type_id), int(slot), int(repeat)) == (
        model.ACTION_TYPE_IDS["sequence"],
        1,
        9,
    )


def test_a_text_macro_types_its_characters(harness) -> None:
    blob = binary.encode_profile(sample_profile())
    typed = [
        chr(int(line.split()[1]))
        for line in run(harness, "replay", "0", blob=blob)
        if line.startswith("type ")
    ]
    assert "".join(typed) == "sudo apt update && sudo apt upgrade -y"


def test_a_drag_holds_the_button_across_the_movement(harness) -> None:
    lines = run(harness, "replay", "1", blob=binary.encode_profile(sample_profile()))
    mouse = [line for line in lines if line.startswith("mouse ")]

    # The pointer is driven into the corner first, so the drag starts from the
    # same pixel it was recorded from. That is a run of hard -127,-127 moves.
    homing = 0
    while mouse[homing] == "mouse move -127 -127":
        homing += 1
    assert homing >= 40, f"only {homing} homing steps"

    drag = mouse[homing:]
    assert drag[0] == "mouse press 1"
    moves = [line for line in drag if line.startswith("mouse move")]
    # Not the three records the host stored: the pad spreads each one over the
    # time it was recorded over, so the count here is reports, not records.
    # What has to hold is where the pointer ends up and that the button was
    # down the whole way.
    assert sum(int(line.split()[2]) for line in moves) == 300
    assert sum(int(line.split()[3]) for line in moves) == -200
    assert "mouse release 1" in drag


def moved(lines: list[str]) -> list[tuple[int, int]]:
    return [
        (int(line.split()[2]), int(line.split()[3]))
        for line in lines
        if line.startswith("mouse move")
    ]


def recorded_drag(counts: int, slices: int, *, per_record: int | None = None):
    """A profile whose slot 0 is `slices` slices of steady rightward motion.

    Built through the real recorder pipeline rather than by hand: the thing
    under test is that the firmware reads back the timing the normalizer wrote.
    """
    from macrokey.recorder.events import MOUSE_MOVE, RawEvent
    from macrokey.recorder.normalize import compile_device_macro, normalize

    events = [
        RawEvent(kind=MOUSE_MOVE, token="move", at=index * MOTION_SLICE_SECONDS,
                 data=(counts, 0))
        for index in range(slices)
    ]
    profile = model.default_profile()
    profile.device_macros = [compile_device_macro(normalize(events))]
    profile.set_action(0, "tap", model.Action(kind="sequence", slot=0))
    return profile


def test_a_move_is_replayed_at_the_speed_it_was_recorded_at(harness) -> None:
    """One record is 50 ms of motion, not a jump.

    The host sums raw mouse counts into 50 ms slices, so replaying a slice as a
    single HID report hands the desktop one huge delta where the mouse had sent
    fifty small ones. Pointer acceleration reads a delta that size as a very
    fast movement and multiplies it, so the macro overshoots -- and by more the
    faster the gesture was drawn. Spending the recorded pause on the movement
    puts the replay back at the speed of the hand, which is what makes the
    acceleration curve cancel instead of compound.
    """
    blob = binary.encode_profile(recorded_drag(counts=100, slices=5))

    steps = moved(run(harness, "replay", "0", blob=blob))

    assert sum(dx for dx, _ in steps) == 500, "the pointer must still land there"
    assert all(dy == 0 for _, dy in steps)
    # 100 counts over 50 ms is 3 counts per report, against the 2 the mouse
    # itself sent -- reports are paced at 3/2 of the USB frame rather than at
    # the frame, so a late one still has room (Config.h explains why). Before
    # any of this it was five reports of 100.
    assert max(abs(dx) for dx, _ in steps) <= 4
    assert len(steps) >= 150


def test_a_fast_move_leaves_room_between_reports(harness) -> None:
    """Pacing must not aim a report at every USB frame.

    The frame is the floor, not a budget. At one report per frame a report
    delayed by anything -- the pixel's bit-bang holding interrupts off, a
    busier USB device once the editor opens the serial port -- has already
    missed its deadline, and `emitMove` paces against an absolute deadline so
    it cannot catch up. The gesture stretches, and a desktop with pointer
    acceleration on multiplies the slower movement by less: the macro lands
    short, by more the faster it was drawn. That was reported on Windows as
    "the macro moves less far when the app is open", and it is the app opening
    the serial port that made the difference.

    A 50 ms slice has 50 frames on a board polled every millisecond. Asking for
    all 50 is what left no room; this holds the replay to comfortably fewer
    while the pointer still travels exactly as far.
    """
    slices = 5
    blob = binary.encode_profile(recorded_drag(counts=100, slices=slices))

    steps = moved(run(harness, "replay", "0", blob=blob))

    assert sum(dx for dx, _ in steps) == 500, "the distance is not negotiable"
    # Read off the firmware rather than restated here: a board that has to poll
    # more slowly gets fewer frames to fit reports into, and the room this test
    # is about is the ratio, not a count.
    built = fields(run(harness, "layout"))
    frames_per_slice = built["move_slice_ms"] // built["hid_poll_interval_ms"]
    per_slice = len(steps) / slices
    assert per_slice <= frames_per_slice * 0.8, (
        f"{per_slice:.0f} reports into {frames_per_slice} frames leaves no room "
        "for a late one"
    )


def test_a_slice_too_long_for_one_record_is_still_one_slice(harness) -> None:
    """A move past 127 counts becomes several records, and they share the pause
    that follows rather than each taking it -- otherwise splitting a slice
    would stretch the gesture to several times the time it was drawn in."""
    blob = binary.encode_profile(recorded_drag(counts=500, slices=3))

    steps = moved(run(harness, "replay", "0", blob=blob))

    assert sum(dx for dx, _ in steps) == 1500
    # 500 counts across one 50 ms slice is 16 a report at the 3/2 pacing,
    # however many records the host needed to write it down. Still a long way
    # below a flick: the whole point of slicing is that no single report is
    # large enough for the acceleration curve to multiply.
    assert max(abs(dx) for dx, _ in steps) <= 17


def test_authored_pauses_do_not_truncate_the_keys_after_them(harness) -> None:
    """MK_MACRO_MAX_RUN_MS used to be a plain wall clock. A recording with more
    than ten seconds of delays -- a real drag-then-Esc macro -- died before the
    Esc, and the pad looked like it had dropped the key. Authored waits extend
    the deadline; only runaway HID work spends the budget.
    """
    profile = model.default_profile()
    profile.device_macros = [
        [
            model.Action(kind="delay", delay_ms=12000),
            model.Action(kind="key", hotkey="esc"),
        ]
    ]
    lines = run(harness, "replay", "0", blob=binary.encode_profile(profile))
    # KEY_ESC is 0xB1 = 177 in Keyboard.h.
    assert "key press 177" in lines
    assert "key release 177" in lines


def test_a_text_run_that_overruns_its_slot_stops_the_macro(harness) -> None:
    """A text header says how many characters follow. Its end was computed in a
    byte, so a header late in a long slot wrapped: record 200 claiming 200
    characters worked out to 268, which truncated to 12 -- inside the slot, so
    the truncation check passed, and *behind* the header, so the macro replayed
    the same stretch for ever. The runaway deadline could not end it either,
    because every character pushes the deadline out by the pause it then waits.

    The pad cannot be made to hold such a slot by this app, and the profile CRC
    rules out getting there by corruption -- but the failure is a keypad that
    types nothing and answers nothing until it is unplugged, so the guard is
    worth having be a guard.
    """
    profile = model.default_profile()
    blob = bytearray(binary.encode_profile(profile))

    count = 210
    blob[binary.MACRO_OFFSET] = count
    base = binary.MACRO_OFFSET + binary.MACRO_INDEX_SIZE
    for index in range(count):
        at = base + index * binary.RECORD_SIZE
        blob[at : at + binary.RECORD_SIZE] = bytes(3)
    # Something visible inside the stretch the wrap would replay again.
    marker = model.Action(kind="key", hotkey="esc").encode()
    blob[base + 50 * 3 : base + 50 * 3 + 3] = bytes(marker[:3])
    # 1 + (200 + 2) // 3 = 68 records past record 200, which is 268 -> 12.
    blob[base + 200 * 3 : base + 200 * 3 + 3] = bytes((model.ACTION_TYPE_IDS["text"], 200, 0))
    crc = binary.crc16(bytes(blob[binary.HEADER_SIZE :]))
    blob[12], blob[13] = crc & 0xFF, crc >> 8

    lines = run(harness, "replay", "0", blob=bytes(blob))

    # KEY_ESC is 0xB1 = 177. Once: the run is refused as truncated and the
    # macro ends there. Looping, it is pressed until the deadline gives out.
    assert lines.count("key press 177") == 1


@pytest.mark.parametrize("slot", [0, 1])
def test_replay_never_leaves_a_key_or_button_held(harness, slot: int) -> None:
    """A press the host never sees released is a key it believes is still down,
    and that is indistinguishable from the keyboard having died. Every macro
    has to end with everything back up, however it ended."""
    lines = run(harness, "replay", str(slot), blob=binary.encode_profile(sample_profile()))

    held_keys: set[int] = set()
    held_buttons: set[int] = set()
    for line in lines:
        parts = line.split()
        if line.startswith("key press"):
            held_keys.add(int(parts[2]))
        elif line.startswith("key release-all"):
            held_keys.clear()
        elif line.startswith("key release"):
            held_keys.discard(int(parts[2]))
        elif line.startswith("mouse press"):
            held_buttons.add(int(parts[2]))
        elif line.startswith("mouse release"):
            held_buttons.discard(int(parts[2]))

    assert held_keys == set(), f"keys still held: {sorted(held_keys)}"
    assert held_buttons == set(), f"buttons still held: {sorted(held_buttons)}"


# ------------------------------------------------------------------ serial --


def stocked_profile() -> model.Profile:
    """A pad that is *not* at its defaults, so a reset has something to undo."""
    profile = model.default_profile()
    profile.brightness = 200
    profile.set_action(0, "double", model.Action(kind="key", hotkey="ctrl+z"))
    return profile


def test_reset_refreshes_what_the_rest_of_the_firmware_had_cached(harness) -> None:
    """`RESET defaults=1` rewrites the keymap under two things that had read it.

    The engine caches which keys have a double binding -- only those pay the
    double-tap delay -- and the pixel is driven from the LED controller's own
    copy of the brightness. Neither was told, so after a factory reset from the
    editor's Reset button a key whose double binding had just been erased still
    deferred its tap and then answered a double-tap with the unbound colour,
    and the pixel kept a brightness the app no longer showed. Until it was
    unplugged, which is not something the button says to do.
    """
    blob = binary.encode_profile(stocked_profile())

    state, replies = serial(harness, blob, "RESET defaults=1")

    assert state["mask_before"] == 0b1 and state["bright_before"] == 200
    assert state["mask_after"] == 0, "the erased double binding still defers its tap"
    assert state["bright_after"] == 64, "the pixel kept the old brightness"
    assert replies == ["OK"]


def test_a_written_profile_lights_the_pixel_at_its_own_brightness(harness) -> None:
    """The same staleness on the other write path.

    The GUI hid this by sending `LED bright=` before writing the profile, but
    `macrokey push` does not, so a profile whose brightness had changed took
    effect on everything except the light.
    """
    dim = stocked_profile()
    dim.brightness = 12
    state, _ = serial(harness, binary.encode_profile(stocked_profile()),
                      *profile_transfer(binary.encode_profile(dim)))

    assert state["bright_before"] == 200
    assert state["bright_after"] == 12


def test_boot_is_refused_where_there_is_no_way_into_the_bootloader(harness) -> None:
    """The AVR arm jumps to Caterina and never returns; every other build has to
    say it cannot, because a BOOT that silently did nothing looks exactly like a
    pad that stopped answering -- at the moment someone is re-flashing it.
    """
    _, replies = serial(harness, binary.encode_profile(model.default_profile()), "BOOT")

    assert replies == ["ERR code=unsupported"]


@pytest.mark.parametrize("board", BOARDS, ids=[board.id for board in BOARDS])
def test_every_board_reports_the_name_it_is_registered_under(
    build_harness, board: Board
) -> None:
    """`HELLO board=` is how the app picks a layout and a firmware image.

    A header whose MK_BOARD_NAME does not match its `Board.id` produces a pad
    the app cannot identify, which then falls back to the default board -- the
    smallest one -- and reports a fill against the wrong ceiling.
    """
    lines = run(build_harness(board), "serial", "IDENT\n",
                blob=binary.encode_profile(model.default_profile(),
                                           profile_size=board.profile_size))
    hello = [line for line in lines if line.startswith("HELLO")]
    assert hello, f"{board.id} did not answer IDENT: {lines}"
    assert f"board={board.id}" in hello[0]
    assert f"bytes={board.profile_size}" in hello[0]


def test_every_board_has_a_header_and_a_page(board_files) -> None:
    """The three files a board needs, held together.

    Adding a board is a registry entry, a firmware header, and a doc page, and
    the failure mode of forgetting one is not a build error -- it is a board
    that works until someone needs the page that was never written.
    """
    missing = [name for name, path in board_files.items() if not path.exists()]
    assert missing == [], f"missing: {missing}"


@pytest.fixture(params=BOARDS, ids=[board.id for board in BOARDS])
def board_files(request) -> dict[str, Path]:
    board: Board = request.param
    header = board.id.replace("-", "_")
    # The 32u4 header is named for its part, not its id, because `promicro` on
    # its own stopped being unambiguous the moment there were two of them.
    candidates = [ROOT / "firmware" / "src" / "boards" / f"{header}.h"]
    if board.id == "promicro":
        candidates.append(ROOT / "firmware" / "src" / "boards" / "promicro_32u4.h")
    return {
        "firmware header": next((path for path in candidates if path.exists()), candidates[0]),
        "docs page": ROOT / board.docs_page,
    }


def test_the_harness_is_built_from_the_real_sources() -> None:
    """A harness quietly compiling its own copy would prove nothing."""
    text = HARNESS.read_text()
    assert '#include "Profile.h"' in text and '#include "KeyEngine.h"' in text
    for name in SOURCES:
        assert (FIRMWARE / "src" / name).exists(), name


def test_the_stubs_do_not_shadow_firmware_headers() -> None:
    """The stubs stand in for the Arduino core, never for anything in src/."""
    stubs = {path.name for path in (FIRMWARE / "test" / "stubs").rglob("*.h")}
    sources = {path.name for path in (FIRMWARE / "src").glob("*.h")}
    assert stubs & sources == set(), f"stub shadows a real header: {stubs & sources}"


if __name__ == "__main__":  # pragma: no cover - convenience
    sys.exit(pytest.main([__file__, "-v"]))
