maduinos/macroKey/(commit log)

2026-08-02 refactor: split the project into arduino, host, and docs trees
    The firmware was a single 05_macrokey.ino sketch and the host application a
    single macro_key_app.py, which left no place for shared structure as either
    side grew.
    Firmware moves to arduino/macrokey with src/ split by concern: ButtonInput,
    KeyEngine, LedController, LedEffects, HidBackend, Profile, SerialProtocol,
    Config, ActionTypes, and Util.
    The host application moves from python_app to host/ as an installable
    macrokey package (host/pyproject.toml, version 0.3.0) with cli, app, ui, and
    device submodules; macros/ moves with it. Adds docs/ARCHITECTURE.md,
    docs/PROTOCOL.md, and docs/HARDWARE.md.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
2026-08-03 feat: target Pro Micro with a single WS2812B, and document how to use it
    The build is a Pro Micro (5V/16MHz) with one WS2812B, not a Leonardo with an
    eight-pixel strip. That changes a pin that did not exist and exposes two bugs.
    Firmware:
    - Move the LED data pin from D11 to A0. The Pro Micro does not break out
    D11/D12/D13 at all, so the previous setting could not be wired. A0 avoids
    SDA/SCL and SPI and sits on the same header as VCC and GND.
    - MK_BOARD_NAME is now promicro; MK_LED_COUNT drops to 1.
    - Fix notePress dropping every key past the pixel count. With one pixel only
    key 1 flashed; surplus keys now fold onto the last pixel.
    - MK_LED_MAX_MILLIAMPS 400 -> 100. One pixel cannot ex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
    [Config.h, LedController.cpp, binary.py, model.py]
2026-08-04 refactor: flatten the layout and move the editor to PySide6
    The repository went arduino/ + host/ + docs/, which meant two hops to reach
    either half of the code. Firmware is now firmware/ and the Python package sits
    at the root, so `pip install -e .` and `arduino-cli compile ... firmware` both
    run from where you already are.
    - arduino/macrokey/ -> firmware/, sketch renamed to firmware.ino so the
    filename keeps matching its folder.
    - host/macrokey/ -> macrokey/, host/pyproject.toml -> pyproject.toml.
    - docs/manual.html and docs/wiring.html move to the top level and lose about
    60% of their length. The pin map and the full wiring diagram stay; the prose
    around them, the GUI mockup, the re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
2026-08-06 fix: stop turning host token 0 and key 0 into -1
    `Message.int(key, -1) or -1` looks like a default but is not: a legitimate
    0 is falsy, so `or` replaced it with the fallback. Every event field parsed
    that way lost the value 0.
    That made the default profile's first host slot dead. Layer 1 keys 5-7 carry
    tokens 0, 1 and 2 (Profile.cpp writeDefaults), so pressing key 5 reported
    "No host action bound to token -1" and nothing ran. Key 1 (`k=0`) was also
    reported as key -1 by `macrokey monitor`.
    `Message.int` now always returns an int, which makes the `or` redundant at
    every call site rather than merely wrong at four of them.
    Adds tests/, which pyproject already pointed `testpaths` at.
    Co-Auth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
    [client.py, protocol.py, test_protocol.py]
2026-08-06 feat: edit host actions and watch device events in the app
    Two gaps meant the app could not be used without a text editor and a second
    terminal: host actions had to be written into profile.json by hand, and the
    only way to see what a key did was `macrokey monitor`.
    Host Actions tab
    Add, edit and remove the work behind a token. The form is generated from
    each handler's new `param_spec`, so registering an action type gives it an
    editor for free -- the "extend by registering, not by editing" rule now
    covers the UI too. "Test run" fires the action on the runner's own thread,
    the same path a key press takes. "Bound to" lists the slots using it.
    Event log
    A panel under the slot grid,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
2026-08-08 feat: make the pixel an ambient status light instead of a keypress blinker
    The pad shipped with a resting colour per layer and a hard white flash on every
    press, which on a single pixel meant it was lit all day and the only thing it
    ever really said was "a key moved". Rebuilt around the opposite default: dark
    unless something is actually happening, and what it says comes from AgentPet.
    - The resting palette is black on every layer, in the firmware defaults and in
    the host copy that `macrokey push` writes. Press feedback, host ambient and
    LED_SCENE actions still compose above it, so nothing that had something to say
    lost its voice.
    - Scene changes cross-fade over MK_LED_FADE_MS (500) r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
2026-08-08 fix: make the pad usable -- serial stall, silent edits, unreachable layers
    Sitting down to actually configure the thing turned up a run of problems, the
    worst of which had been making everything feel broken without ever failing.
    Every serial exchange took exactly 200 ms. The read loop asked pyserial for a
    fixed 128 bytes, and read(n) returns early only once it has n bytes -- replies
    here are four, so every single request waited out the full read timeout and then
    took what had arrived long before. Reading what is actually buffered takes a
    profile write from 4.4 s to 54 ms and a ping from 200 ms to 0.9 ms. Nothing was
    failing, so nothing pointed at it; the whole link was just twenty times slo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
    [Config.h, KeyEngine.cpp, LedController.cpp, LedController.h, Profile.cpp, SerialProtocol.cpp, app.py, cli.py]
2026-08-08 feat: bind keys by recording them, and keep recordings on the keypad
    Binding a key meant picking from a dropdown of action kinds -- key, consumer,
    mouse_button, layer_momentary, layer_toggle, host -- and then typing a value
    whose format depended on which one was picked. That is the serial wire format
    showing through the window. Nobody deciding what a key should do is thinking
    about HID usage pages or host action tokens.
    There are only two things a key can be. Either it replays something, and the
    way to say what is to do it; or it changes layer, which is a state change on the
    device and the one binding a recording cannot express. So the dialog offers
    recording, layer, and clear, and the taxo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
    [app.py, store.py, test_recording_placement.py]
2026-08-08 feat: one window per key, a live recording log, and a stop that is not Esc
    Three problems with binding a key, all of them the same problem: you could not
    see what was happening.
    Recording stopped on Esc, so a macro could never contain Esc. That rules out
    closing a dialog, leaving vim insert mode and dismissing a completion popup --
    which are exactly the things worth recording. Stopping is a button now. The key
    is still available for the CLI, which has nowhere to click, and that is the one
    path where the limitation remains.
    Recording showed nothing until it was over. A capture that is picking up
    everything and one that is picking up nothing looked identical until you
    stopped and found out,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
    [app.py, cli.py]
2026-08-08 feat: record the mouse, and keep the click that stops the recording out of it
    Mouse was never captured. MacroKeyApp built the recorder with capture_mouse
    left at its default of False, so the listener was never even started, and
    normalize turned any click that did arrive into an annotated no-op. A recording
    of "right click, then pick the third menu item" produced a macro that did
    nothing at all, and said so only in a line of summary text.
    Buttons and wheel are recorded now, and replayed by the keypad itself: both are
    firmware actions, so a mouse recording still costs nothing on the host. Position
    is deliberately not recorded. A macro that moves the pointer to a remembered
    coordinate is right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
2026-08-08 feat: capture shortcuts by pressing them, read input below the display server
    Three things, all from trying to actually set the pad up.
    Recording captured nothing. Recorder.available() checked whether pynput
    imports, and it does -- pynput has one Linux backend and it speaks X11, which
    under Wayland loads happily through XWayland and then sees only input delivered
    to X11 clients. Typing into a native Wayland window is invisible to it. So the
    recorder reported itself available, ran, and came back empty, which is the worst
    possible combination.
    There is now an evdev backend that reads /dev/input/event* directly, below the
    display server, so it sees every window regardless of compositor. It is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
    [Profile.cpp, app.py, model.py]
2026-08-08 fix: capture the key, not the glyph shift made of it, and let it be typed
    Pressing ctrl+alt+shift+1 filled the field with ctrl+alt+shift+! -- the shifted
    character, which is not a key the keypad has and not something this app can
    parse. The capture read event.text(), the glyph produced, when what a shortcut
    is made of is event.key(), the key before shift is applied. The keypad sends
    modifiers and a key; turning that into "!" is the receiving application's job,
    not something to store.
    The field was also read-only, which made capture the only way in. That is wrong
    for anything awkward or impossible to press into a dialog -- a combination the
    compositor takes first, or a key this keyboard does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
    [app.py, test_shortcut_capture.py]
2026-08-08 fix: Write to device failed on every click, from a Qt signal argument
    `clicked` carries a `checked` boolean. `_push` had an optional `then` callback
    parameter, so wiring it straight to the button meant Qt passed False in as the
    callback. The write itself went out fine; the failure came at the end, when the
    completion handler tried to call False and raised "'bool' object is not
    callable" on the GUI thread. Nothing failed at connect time, nothing failed on
    the click, and the error arrived from a worker callback -- which is why it read
    as "Write to device just does not work".
    The callback parameter had no callers left: the colour picker stopped using it
    when writing became fast enough to apply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
    [app.py, test_toolbar_slots.py]
2026-08-08 fix: stop recordings being world-readable, and say when one caught a secret
    Capture is global by construction: while a recording runs it sees everything
    typed into every window, not just what was aimed at the macro. Start one a
    moment too early, alt-tab to a password prompt, and the password is in the
    recording -- stored verbatim as a text step.
    That file was 0644, so every account on the machine could read it. Profile and
    settings are owner-only now, and so is the directory. Existing files are not
    migrated by this commit; they need chmod once.
    The recorder also points at long typed runs before anything is bound. Real
    macros type short things -- a command, a name, a snippet -- while an unb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
    [app.py, store.py]
2026-08-08 fix: keep answered password prompts out of stored recordings
    A recording of "open a terminal, run apt update" captured the sudo password
    typed at the prompt that followed and wrote it into profile.json, which was
    world-readable at the time. Capture is global by construction, so anything typed
    while a recording runs is in the recording, whether it was aimed at the macro or
    not.
    The shape is recognisable and narrow: a command that prompts, the Enter that
    submits it, then whatever was typed next. That last step is dropped before the
    recording is shown, let alone stored.
    Requiring the Enter is what keeps it from eating real macros. Without it, any
    text following the string "sudo" anywhere woul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
    [app.py, client.py, discovery.py, test_secret_redaction.py]
2026-08-08 feat: replay typed text from the keypad, so recordings stop needing a daemon
    Text was the one thing that forced a recording onto the host. The firmware
    presses keys and has no "type this string" action, so a recording of "open a
    terminal and run a command" became a host action -- and with the daemon stopped,
    which is its normal state now that nothing else needs it, that key was bound,
    looked bound in the editor, and did nothing when pressed.
    Text expands to one key action per character. Uppercase becomes shift plus the
    lowercase key, because the keycode parser lower-cases whatever it is handed;
    shifted symbols already carry their own ASCII value, which is what the Arduino
    keyboard library e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
2026-08-08 fix: record mouse clicks, acknowledge writes on the pad, stop double logging
    Mouse clicks were never captured. evdev returns a code's name as a string, a
    list, or a tuple depending on the table, and BTN_LEFT is the tuple
    ("BTN_LEFT", "BTN_MOUSE"). The unwrapping only handled lists, so every button
    fell through the check and was dropped -- while scrolling, which takes a
    different path, worked. A recording of clicking came back with the clicks
    missing and nothing said why.
    Writing to the device now says so where the person is looking. A status bar
    message is in the wrong place: the thing that changed is the keypad, so the
    pixel flashes green for 600 ms. The window it asks for is the same leng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
    [app.py, cli.py, test_evdev_source.py]
2026-08-08 feat: hold a key to record into it, hold it again to keep it
    Programming the pad no longer needs the window. Hold a key on its own for three
    seconds and the pixel turns red; do the thing; hold the same key again and what
    you did is stored on that key. Close the app and the key still works, because
    the recording is compiled into a device macro whenever it can be.
    The device holds no recording state. It reports "key N was held alone" and the
    host decides whether that starts or finishes -- the two disagreeing about which
    mode they are in is the failure nobody could diagnose from one pixel, and this
    makes it impossible rather than unlikely.
    "On its own" is what keeps it out of ordinary use: th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
    [ButtonInput.cpp, ButtonInput.h, Config.h, KeyEngine.cpp, KeyEngine.h, Profile.cpp, Profile.h, SerialProtocol.cpp]
2026-08-08 feat: drop Write, Read and Save; the pad is kept in step on its own
    All three could only repeat work that had already happened. Editing a key saves
    and writes it, holding a key to record saves and writes it, and connecting now
    reconciles whatever was edited while unplugged. A button that duplicates that is
    at best redundant and at worst forgotten -- and a forgotten Write means the key
    does not do what the screen says it does, with nothing to indicate why.
    Connecting compares the device against the profile and sends it if they differ.
    That is the case the buttons genuinely covered: edit with the pad unplugged,
    plug it in, and until now the pad kept running the old profile silently.
    `macroke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
2026-08-09 feat: text runs on the pad, and stop re-recording eating the storage
    The pad's whole point is working with the app closed, and two things were
    quietly taking that away.
    Re-recording into a key never freed the slot the old macro held. Correcting a
    macro is the ordinary thing to do with one, so sixteen corrections to a single
    key filled all sixteen slots with steps nothing pointed at, and from then on
    every recording fell back to a host action -- which needs this computer running.
    Nothing failed and nothing said so; only the wording in the status bar changed.
    Bindings are cleared before the new recording is placed, and unreferenced
    storage is swept, which also repairs profiles that already le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
    [ActionTypes.h, ButtonInput.cpp, ButtonInput.h, Config.h, HidBackend.h, KeyEngine.cpp, KeyEngine.h, Profile.cpp]
2026-08-09 feat: double-click then hold to record into a key's second slot
    The pad could only ever reach one slot. `_finish` was hardcoded to "tap", so a
    key's double slot could only be filled by opening the editor window -- on a
    device whose whole premise is that you program it by holding its keys.
    The firmware was already letting tap-tap-hold through to the record path:
    `recordFired` is only reset on a press edge that is not the second of a pair.
    So the gesture worked, opened the recorder, and stored the result on the tap
    slot without saying so.
    A plain hold now programs tap and a double-click-then-hold programs double,
    with `EV t=record` carrying `g=`. The pair is spotted from the gap between a
    re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
    [ButtonInput.cpp, ButtonInput.h, KeyEngine.cpp, KeyEngine.h, SerialProtocol.cpp, SerialProtocol.h, app.py, firmware.ino]
2026-08-09 refactor: retire layers, and stop the recorder listening to the pad itself
    Three things that were each making the next change harder.
    The recorder opened every keyboard it could find, and the pad is a USB keyboard,
    so it read its own HID output back. The workaround was to drop *every* captured
    event for 150 ms after any pad keypress -- which also threw away whatever was
    really being typed at that moment. The pad's input nodes are now skipped by USB
    vendor, so there is nothing to work around.
    Auto-repeat had a path that never disarmed. `repeatKey_` was only cleared on a
    `released` event, and only a hold produces one: a tap is pushed with
    released=false and a suppressed key emits nothing at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
    [ActionTypes.h, Config.h, KeyEngine.cpp, KeyEngine.h, LedController.cpp, LedController.h]
2026-08-09 fix: double recording was impossible on any key that already had a macro
    Recording into the double slot means tapping a key and pressing it again inside
    the double-tap window. That first tap fires whatever the key is bound to -- and
    if that is a macro, runMacro blocks loop() and the button scan stops with it.
    The second press was therefore not seen until the macro finished, timestamped
    seconds late, well past the 250 ms window, and read as an ordinary hold.
    So the gesture worked only on keys with nothing on them. On any key worth
    re-recording it silently did the other thing instead: another tap recording,
    overwriting the slot the person was trying to leave alone.
    The scan now runs through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
    [KeyEngine.cpp, KeyEngine.h, SerialProtocol.cpp, firmware.ino, harness.cpp, test_firmware_agreement.py]
2026-08-09 fix: stop the recorder throwing away 150 ms of real typing
    Excluding the pad's own input nodes from evdev removed the reason the
    self-echo blanket existed, but not the blanket. It drops every captured event
    for 150 ms after the pad reports a key -- and with nothing of the pad's able to
    arrive any more, the only thing left for it to throw away was what was actually
    being typed. Touch the pad during a recording and the next 150 ms of the
    recording is gone, which is the recording quietly not containing what it was
    asked for.
    It stays on for pynput, which reports keystrokes with no idea which device made
    them and so has no other defence.
    The backend is also named before the reader thread is st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
    [session.py, test_mouse_recording.py, test_recording_session.py]
2026-08-09 fix: anchor mouse macros to a corner so they click what they clicked
    The kernel reports pointer movement as relative deltas and nothing else, so a
    recorded macro replayed the same deltas from wherever the cursor happened to
    be. Recorded from one place and replayed from another, the whole macro is
    offset by the difference and every click in it lands on something else. Which
    is what "it moves on its own" was.
    Relative was chosen so a macro would survive a window being moved. For a macro
    whose job is to click a particular thing that is the wrong trade.
    The pointer is now parked in the top-left corner when a recording starts, and
    any device macro that touches the pointer begins by going back t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
    [ActionTypes.h, Config.h, HidBackend.h, KeyEngine.cpp, SerialProtocol.cpp, app.py, client.py, model.py]
2026-08-09 fix: show what the pad will run, not only what was captured
    The window and the log listed the captured steps, and the pad runs the compiled
    macro. They are not the same list. A macro that touches the pointer gains a step
    that sends it to the corner first; long text becomes one typed run; a long move
    becomes several. So the window described something the pad was not going to do,
    and the first thing it actually did -- throwing the cursor into a corner --
    appeared nowhere.
    Both now read the stored binding back out of the profile.
    [app.py, session.py]
2026-08-09 fix: an ordinary click was being recorded as a drag
    A press and release counted as a drag if anything at all happened between
    them, and pointer movement counted. Nobody holds a mouse still while clicking
    it, and a gaming mouse at 3200 dpi turns a hand tremor into dozens of counts --
    so essentially every click was stored as press, move, release. Replayed, that
    holds the button down and hauls whatever is under the pointer across the
    screen, from a recording where nothing was ever dragged.
    A drag now needs real travel between the press and the release. A keystroke or
    another button still counts on its own: those only make sense with the button
    held. The drift during a click is dropped rather t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
    [test_drag_recording.py]
2026-08-09 feat: always write a log file, so a bad recording can be read afterwards
    A recording is made with the window unwatched and the pad under a hand. By the
    time it is clear something went wrong, whatever would have explained it has
    scrolled past or was never printed, and the only thing left to do is ask for it
    to be done again. Everything now goes to macrokey.log beside the profile,
    whether or not --verbose was passed.
    [cli.py]
2026-08-09 fix: a recording containing typed text could never be saved
    `Action.to_dict` built a blank instance of the same kind to diff the fields
    against. For text that means `Action(kind="text")` -- an action with no text,
    which `__post_init__` refuses by design. So writing the profile raised "a text
    action needs text" from the one method whose job is to write it down, and every
    recording that contained typed words was lost at save time: the status bar said
    "Recorded, but could not write it to the keypad" and profile.json never changed.
    The defaults are read off the dataclass now instead of by constructing
    something deliberately incomplete.
    Found by reading macrokey.log after a real recording, whic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
    [model.py, test_profile_roundtrip.py]
2026-08-09 release: 0.4.0
    Firmware and host app both 0.4.0, profile schema 2, protocol v1 unchanged.
    They have to be updated together: the profile blob is the same size either way,
    so without the schema byte an out-of-date pad decodes as nonsense rather than
    being recognised. An old EEPROM is rewritten with defaults on first boot.
    This is the release where recording from the pad actually works. The bug that
    made it look broken was in serialising rather than in anything to do with the
    device: `to_dict` built a blank instance of the same kind to diff against, and
    for text that is an action with no text, which the model refuses by design. So
    every recording containing typed words failed at save time and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
    [Config.h]
2026-08-09 feat: typing speed setting, and keep the log out of the terminal
    Replay is faster than the recording was, by design: consecutive characters are
    merged into one run with no timing kept, because reproducing human typing speed
    is almost never wanted. But nothing could be done when it was too fast -- a
    terminal still starting, a field that validates as you type -- so the per
    character pause is a setting now, on the toolbar next to brightness.
    It lives on the profile rather than in the app's settings, because the pad
    replays macros with the app closed and therefore has to know. It goes in header
    byte 11, which was reserved and already written as zero, and zero still means
    "whatever the firmware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
    [Config.h, KeyEngine.cpp, Profile.cpp, Profile.h, app.py, binary.py, cli.py, harness.cpp]
2026-08-09 docs: flash with compile --upload, not upload alone
    `arduino-cli upload` sends the last build output rather than building first, so
    bumping the version and then uploading flashed the previous binary and the pad
    reported the old version back.
2026-08-12 release: 0.5.0 pad-only app, GUI PyInstaller, docs refresh
    Drop host/clipboard/AgentPet runtime so the pad is HID-only and the PC app
    is config/record only. Ship via build_release.sh, harden recording, add
    macro-run LED cues, and align manuals with the new layout.
2026-08-13 Keep hold-to-record as the only capture path and stop truncating long macros.
    Authored delays no longer spend the firmware runaway budget, so keys after long pauses (e.g. Esc) still replay; the app now only toggles mouse capture and shows a live log.
    [Config.h, KeyEngine.cpp, KeyEngine.h, app.py, describe.py, session.py, slot_dialog.py]
2026-08-14 Show shared macro EEPROM storage usage in the status bar.
    Add macro_storage_usage helper and refresh the pad editor indicator from the
    combined 16-slot record pool.
2026-08-18 Improve recording device handling
2026-08-25 ci: build Linux/Windows binaries and publish them to a release
    main으로 push될 때마다 롤링 `latest` 프리릴리스를, `v*` 태그 push 시에는
    정식 릴리스를 만들고 두 실행 파일을 자산으로 올린다. 빌드는 로컬과 같은
    ./build_release.sh 를 쓰고, 테스트는 별도 잡에서 한 번만 돌린다.
    Claude-Session: https://claude.ai/code/session_011RqFDdALyMxBYhT4eG1yf1
2026-08-25 ci: install Qt runtime libs before pytest
    ubuntu 러너에는 libEGL 등이 없어 PySide6 import가 실패했다. 테스트 잡에도
    빌드 잡과 같은 세트를 설치한다.
    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
2026-08-25 ci: drop libxcb-xinerama4 (noble 러너에 없는 패키지)
    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
2026-08-26 ci: pin ubuntu runners to 22.04
    ubuntu-latest(24.04, glibc 2.39)에서 빌드한 바이너리는 GLIBC_2.38을 요구해
    22.04에서 실행되지 않았다. 러너를 22.04로 고정해 하위 호환을 확보한다.
    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
2026-08-26 ci: read version with sed instead of tomllib
    22.04 러너의 시스템 python은 3.10이라 tomllib이 없다. 릴리스 잡은 python이
    필요 없으므로 pyproject의 version 한 줄만 sed로 뽑는다.
    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
2026-08-26 release: 0.5.1 — 툴바 재동기화, 타이핑 속도 표기, Reset 버튼
    앱만 변경. 펌웨어는 0.5.0 그대로다.
    - 툴바의 Brightness/Typing이 창을 만들 때 한 번만 값을 읽어, Pull로 프로필을
    통째로 교체하면 화면과 프로필이 영영 어긋났다. _refresh_all()이 다시 맞춘다.
    - 타이핑 속도에서 "default" 특수값을 없앴다. 범위가 1..255 ms가 되고 패드
    기본값은 5 ms로 보인다. 0이 "default"였을 때는 한 칸 올리면 1 ms — 방금 떠난
    기본값보다 다섯 배 빠른 값이 나왔다. 저장은 계속 0이다: 갓 flash한 패드의
    헤더 바이트가 0이고 프로필 비교가 raw 바이트라,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
    [app.py, model.py, store.py, test_mouse_recording.py, test_reset_everything.py, test_toolbar_resync.py, test_toolbar_slots.py]
2026-08-26 fix(tests): 통과하고도 종료 시 segfault로 죽던 테스트 실행
    CI가 "317 passed"를 찍고 exit 139로 실패했다. 두 가지가 겹쳤다.
    - MainWindow가 실행 끝까지 살아남으면 Qt가 QApplication을 해체한 뒤 Python
    종료 GC가 남은 것을 훑다가 PySide6가 segfault한다. 세션 스코프 teardown에서
    Qt가 아직 서 있는 동안 top-level 위젯을 닫고 삭제한다. 모듈 하나를 여러
    테스트가 창 하나로 공유하므로 테스트마다 닫으면 안 된다.
    - test_reset_everything의 FakeDevice에 disconnect()가 없어 closeEvent가
    MacroKeyApp.close()에서 터졌고, 그래서 창이 끝내 파괴되지 않았다.
    둘 다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
    [test_reset_everything.py]
2026-08-26 release: 0.5.2 — UI 폰트가 크면 툴바 글자가 잘리던 문제
    Reset… 이 잘린다는 제보로 찾았지만, 버튼 하나가 아니라 툴바 줄 전체가 창
    최소 너비(하드코딩 820 px)에 들어가지 않는 문제였다. 한 줄이고 줄바꿈을 하지
    않으므로 좁아지면 위젯을 서로 겹쳐 밀어낸다 — 포트 이름이 Connect 버튼 밑으로
    들어가고 라벨이 전부 잘린다. 9 pt에서만 우연히 맞았다.
    - 버튼이 자기 라벨보다 좁아지지 않는다. Connect는 가장 긴 상태값
    (Connecting...) 기준이라 상태가 바뀌어도 크기가 흔들리지 않는다.
    - Typing 스핀박스의 고정 84 px 제거. 가장 큰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
    [app.py, test_toolbar_fits.py]
2026-08-27 release: 0.6.0 — 마우스 녹화·연결·UI 안정성 개선
2026-08-28 release: 0.7.0 — 리셋·매크로 재생 버그, 자동 재연결, RP2040 이음매
    펌웨어를 다시 flash해야 합니다. 앞의 세 가지는 패드 안에서만 고쳐집니다.
    - RESET defaults=1 과 PROF commit 이 키맵을 새로 쓰면서, 그것을 캐시해 둔
    엔진의 double-tap 마스크와 LedController 의 밝기에 알리지 않던 문제.
    Reset 버튼을 누르면 방금 지워진 double 바인딩이 여전히 탭을 250 ms 미뤘고,
    픽셀은 앱이 더는 보여주지 않는 밝기를 유지했습니다.
    - 텍스트 런의 끝 위치를 1바이트로 계산해, 슬롯 뒤쪽의 헤더가 268 -> 12 로
    잘리면서 매크로가 헤더보다 앞으로 점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
    [ActionTypes.h, ButtonInput.cpp, ButtonInput.h, Config.h, KeyEngine.cpp, KeyEngine.h, LedController.cpp]
2026-08-28 release: 0.8.0 — replay mouse moves at recorded speed to cancel pointer acceleration.
    Spread recorded deltas across their timing window in firmware and optionally prompt to flatten GNOME pointer acceleration during mouse macro capture.
2026-08-30 docs: ProMicro RP2040 배선 가이드 추가
    제네릭 클론(TENSTAR ProMicro RP2040, USB-C · 16 MB) 기준의 배선·포팅
    가이드입니다. 32u4용 wiring.html과 같은 스타일·인쇄 CSS를 씁니다.
    - 버튼 8개가 GP2–GP9로 왼쪽 열에 연속으로 들어갑니다. 32u4에서 D10만
    반대쪽 줄로 넘어가던 조립 사고 지점이 없어집니다.
    - 보드 GP17에 RGB LED가 있지만 WS2812 계열이 아니라 Adafruit_NeoPixel로
    구동되지 않습니다. 외부 WS2812B 모듈이 필수이고, RP2040이 3.3 V 로직이라
    모듈을 5 V가 아닌 3V3에서 급전합니다(3V3·GND·GP21).
    - 3.3 V 급전의 근거와 한계를 데이터시트 값으로 정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
2026-08-31 release: 0.9.0 — ProMicro RP2040 16 MB 매크로 저장소 지원
    AVR 배치는 그대로 둔 채 schema 3을 추가해, 장치가 HELLO의 bytes= 로 알려주는
    프로필 크기에 따라 레이아웃을 고릅니다. AVR은 1,024 B에 308 레코드, RP2040은
    65,520 B에 21,801 레코드입니다. Storage 구현을 헤더에서 분리하고, Ubuntu에서
    USB 시리얼 포트를 열 수 있게 하는 tools/setup_linux_serial.sh 를 추가했습니다.
    profile_layout 이 device 를 요구하게 되면서 device 스텁이 없던 두 테스트가
    깨졌던 것도 같이 맞췄습니다.
    Claude-Session: https://claude.ai/code/session_0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
2026-09-01 release: 0.10.0 — 한국어 UI, Windows 포인터 가속, 매크로 손실 복구
    UI 언어를 한국어/영어로 고를 수 있습니다. 기본값은 시스템 로케일 자동 감지이고,
    바꾼 언어는 다음 실행부터 적용됩니다 — 라벨과 툴팁, 버튼에 고정된 폭까지 전부 창을
    만드는 시점에 정해지기 때문입니다.
    Connect 버튼의 폭 계산이 영어 문자열을 직접 들고 있었습니다. 번역만 하고 두었으면
    "연결 해제"가 잘렸을 자리입니다. 버튼은 줄어들기를 거부하지 않고 글자를 생략하므로
    어디에도 오류가 나지 않습니다. 슬롯 편집기의 안내문 높이도 영어 네 줄로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
2026-09-02 fix: 창 제목과 --version이 한 릴리스 뒤처져 있던 문제
    `pyproject.toml`과 `macrokey.__version__`은 같은 숫자의 사본 두 개인데
    둘을 잇는 것이 없었다. 0.10.0이 나갔는데 창 제목은 v0.9.0이라고 말하고
    있었다 — 어긋나도 아무 데서도 실패하지 않으니 드러날 길이 없었다.
    사용자가 자기가 무엇을 쓰는지 잘못 알게 되고, 그건 그 버전으로 버그를
    신고할 때 가장 문제가 된다.
    `__version__`을 0.10.0으로 맞추고, 이 리포가 이미 쓰는 방식대로
    (`test_firmware_agreement.py`, `test_i18n.py`) 둘을 같은 숫자에 묶는
    테스트를 붙였다. tomllib 대신 정규식으로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
    [test_version_agreement.py]
2026-09-02 fix: 릴리스 바이너리에 CLI가 아예 없던 문제
    PyInstaller가 묶는 것은 `main.py`인데 그 파일이 `sys.argv`를 아예 읽지
    않았다. `run_gui()`만 부르고 끝나니 `--version`, `ports`, `info`, `push`,
    `pull`, `record` 전부가 소스 체크아웃에서만 닿는 기능이었다. 릴리스를
    받은 사람이 `--version`을 주면 버전을 찍는 대신 창이 떴다.
    바로 앞 커밋이 고친 `--version`이 정작 릴리스물에서는 닿을 수 없는
    자리에 있었던 셈이다.
    `cli.main()`으로 위임한다. 인자가 없으면 `command="gui"`로 떨어져
    예전과 똑같이 창이 뜬다.
    Windows 빌드는 `--windowed`라 GUI 서브시스템 실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
    [runtime.py, test_frozen_cli_entry.py]
2026-09-02 release: 0.11.0 — 보드를 늘릴 수 있는 구조, 펌웨어 자동 설치
    보드가 하나 늘 때마다 여섯 군데를 찾아 고쳐야 했고, 그중 하나를 놓쳐도
    빌드는 깨지지 않았다. 그 구조를 양쪽에서 한 곳으로 모으고, 그 위에
    펌웨어 설치를 얹었다. 펌웨어 0.9.2 — 동작은 같고, 재배치된 소스에서
    다시 빌드됐다는 표시다.
    ## 보드가 한 곳에 모였다
    보드 분기가 `Config.h`, `Profile.h`, `Storage.cpp`, `SerialProtocol.cpp`에
    `#if defined(ARDUINO_ARCH_RP2040)` 여섯 개로 흩어져 있었다. 세 번째 보드는
    여섯 곳을 다 찾아야 했고, 놓친 한 곳은 컴파일 에러가 아니라 조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
2026-09-02 ci: arduino-cli 설치 스크립트가 BINDIR을 만들지 않는다
    새로 넣은 firmware 잡이 첫 실행에서 실패했다.
    /home/runner/.local/bin ($BINDIR) folder not found.
    Please create it before continuing.
    설치 스크립트는 BINDIR이 없으면 만들지 않고 거부한다. 러너에는
    ~/.local/bin이 없다. 먼저 만든다.
    Claude-Session: https://claude.ai/code/session_01HZPs4FVv1pydZoUXPHZWLu
2026-09-02 fix: SparkFun:avr는 arduino:avr 없이는 빌드되지 않는다
    CI의 첫 펌웨어 빌드가 이렇게 실패했다.
    Invalid FQBN: missing platform release arduino:avr
    referenced by board SparkFun:avr:promicro:cpu=16MHzatmega32U4
    벤더 코어는 베이스 플랫폼 위에 얹히고, 그것을 알아서 끌어오지 않는다.
    이 저장소에서 지금까지 드러나지 않은 이유는 단순하다 — 개발 기계에는
    arduino:avr가 이미 깔려 있었다. 깨끗한 기계에서만 나는 실패이고, 그건
    CI와 남의 첫 빌드를 뜻한다.
    `Board.core`를 `cores` 튜플로 바꿔 설치 순서대로 적는다. 마지막 항목이
    FQBN을 소유한 플랫폼이어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
    [boards.py, test_boards.py]
2026-09-02 fix: RP2040에서 마우스 매크로가 열 배 느리게 재생되던 문제 (0.11.1)
    증상은 "RP2040에서만 마우스 매크로가 느리다"였다. 32u4에서는 멀쩡했다.
    원인은 HID 엔드포인트의 폴링 간격이다. arduino-pico는 이렇게 잡는다.
    int usb_hid_poll_interval __attribute__((weak)) = 10; // USB.cpp:65
    AVR 코어의 HID 엔드포인트는 1 ms다. 열 배 차이다.
    녹화된 움직임 한 조각(50 ms)은 1 ms에 리포트 하나씩 보내 재생된다 — 그래야
    데스크톱의 가속 곡선이 재생에도 손에 적용된 것과 똑같이 적용되어 상쇄된다.
    엔드포인트가 10 ms마다 열리면 그 리포트들이 하나하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
    [Config.h, KeyEngine.cpp, app.py, board.h, firmware.ino, harness.cpp, promicro_32u4.h, promicro_rp2040.h]
2026-09-03 release: 0.12.0 — 대각선 마우스 이동 손실 수정, 앱·펌웨어 자동 업데이트
    녹음이 포인터 이동을 조용히 버리던 경로 넷을 고치고, 앱과 펌웨어가 스스로
    최신을 따라가게 합니다. 펌웨어 이미지는 그대로입니다(0.9.3) — 재플래시 불필요.
    녹음 (전부 pynput 경로 = Windows. evdev는 3번만 해당)
    1. 에디터 창 사각형 필터가 클릭·휠뿐 아니라 포인터 위치 표본에도 걸려 있었습니다.
    창 위를 지나간 이동량이 통째로 사라져 매크로가 그만큼 못 미친 곳에서 멈춥니다.
    화면을 가로지르는 대각선은 가운데 놓인 창을 거의 항상 지나가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
    [app.py, cli.py, images.py]
2026-09-03 test: 테스트가 개발자 기계에 있던 것에 기대고 있었다
    CI가 0.12.0에서 잡았습니다. 로컬 594개 통과, 러너에서 8개 실패 — 코드가 아니라
    테스트가 두 가지를 가정하고 있었습니다.
    - **`firmware/prebuilt/*.hex`는 커밋되지 않는 빌드 산출물입니다.** CI는 별도 잡에서
    굽고 test 잡은 그걸 내려받지 않으므로, 깨끗한 체크아웃에는 아예 없습니다.
    제 기계에는 예전 빌드가 굴러다녀서 통과했을 뿐입니다 — 즉 CI뿐 아니라 모든
    기여자의 첫 실행에서 실패했을 것입니다.
    "이 빌드가 품은 이미지"가 필요한 테스트에는 이제 `bundled_fir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
2026-09-03 fix: 앞 창으로 간 클릭이 에디터 창 사각형에 걸려 사라지던 문제
    증상은 "엑셀에서 칸을 클릭해 이동하는 매크로가 안 먹는다"였습니다. 포인터는 칸까지
    정확히 가는데 거기서 아무것도 누르지 않습니다. 기기에 들어있던 매크로를 세어보면
    그대로입니다 — mouse_move 40개, delay 34개, mouse_button 0개. 클릭이 있었어야 할
    자리에는 delay 380/800/520 ms만 남아 있습니다.
    녹음 중 이 창을 클릭한 것이 매크로 스텝이 되지 않도록 창 사각형 안의 클릭을 버리는데,
    사각형은 창이 아닙니다. 녹음은 패드로 시작하므로 사람은 곧바로 매크로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
    [app.py, test_recording_over_another_window.py]
2026-09-04 fix: 에디터 창 사각형이 앞 창으로 간 클릭을 계속 버리고 있었다 (0.12.1)
    증상은 "엑셀에서 칸을 클릭해 이동하는 매크로가 한 칸 건너 한 번씩만 먹는다"였습니다.
    기기에서 Windows 녹음을 읽어내 펴봤습니다. 포인터는 일곱 군데에 멈추는데 클릭은 네
    개뿐이고, 사라진 세 개는 전부 에디터 창 좌표 안(x 1227~1612, y 469~661), 살아남은 네
    개는 전부 밖입니다. 마지막 스텝이 결정적입니다 — 매크로는 칸을 클릭하지도 않고 그
    자리에서 `=sum`을 칩니다. 클릭 없이 셀에 타이핑이 될 리가 없습니다.
    12047a7에서 "이 창이 활성일 때만 사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
    [app.py, test_mouse_recording.py, test_recording_over_another_window.py]
2026-09-04 release: 0.13.0 — 앱 아이콘, Windows Git Bash 빌드 수정
    앱에 아이콘이 없어 어느 플랫폼에서도 툴킷 기본값이 뜨고 있었습니다. 8키 4×2 패드와
    그 아래 픽셀 하나를 그립니다. 32px 미만은 4열이 뭉개지므로 2×2 단순형을 따로 그리고,
    각 크기를 4배 캔버스에서 그려 줄입니다. Linux는 PyInstaller가 --icon을 무시하므로
    앱이 실행 중에 창 아이콘을 직접 지정합니다.
    그리고 Windows Git Bash 빌드가 방금 설치한 의존성을 없다고 말하며 죽던 문제를
    고칩니다. PyInstaller로 가는 경로는 전부 cygpath로 변환하면서 PYTHONPATH만 POSIX
    경로로 내보내고 있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
    [app.py, runtime.py, test_build_release_environment.py]
2026-09-04 release: 0.14.0 — 빠른 마우스 매크로가 짧게 떨어지던 문제, 업데이트 내역 표시
    emitMove가 리포트 예산을 USB 프레임 그 자체로 잡고 있었다. 50 ms 슬라이스에
    리포트 50개, 여유 0.05 ms. 프레임은 바닥이지 예산이 아니라서, 픽셀 비트뱅이나
    에디터가 연 시리얼 포트 때문에 리포트가 조금만 늦으면 데드라인을 넘고, 절대
    시각이라 따라잡지도 못한다. 늘어진 제스처를 가속 곡선이 덜 곱해 매크로가 짧게
    떨어졌다 — "앱을 켜두면 매크로가 덜 간다"의 정체다. 이제 프레임의 3/2로 뿌려
    여유가 0.61 ms다. 이동 거리는 그대로고 느린 이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
2026-09-04 test: 새 창 픽스처가 시작 타이머의 모달을 막지 않고 있었다
    test_update_ui의 window 픽스처가 _autoconnect만 막고 _maybe_fix_capture는
    그대로 뒀다. 그건 QMessageBox.question으로 모달을 여는데, __init__이 400 ms
    타이머로 걸어두므로 이 창을 만든 테스트가 아니라 그 뒤에 Qt를 돌리는 아무
    테스트나 teardown에서 터진다. offscreen에는 누를 사람이 없어 그대로 멈춘다.
    CI가 정확히 그렇게 죽었다 — teardown의 _destroy_widgets_before_exit 안에서
    _maybe_fix_capture가 답을 기다리며 멈췄고, 로컬에서는 간헐적으로 재현됐다.
    다른 UI 테스트 파일들은 이미 둘 다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
2026-09-04 release: 0.14.1 — 0.14.0이 지목한 원인이 틀렸다
    증상은 "앱을 켜면 마우스 매크로가 조금씩 어긋난다"였고, 0.14.0은 이것을 재생
    페이싱과 포인터 가속 탓으로 돌렸다. 실제 원인은 Windows 11의 가운데 정렬 작업
    표시줄이었다. 매크로가 작업 표시줄 아이콘을 클릭하는데, 열린 앱이 하나 늘면
    아이콘이 전부 밀린다 — macroKey를 켜는 것 자체가 그 하나다. 재생 거리가 아니라
    목표 좌표가 움직인 것이다.
    가속 가설과 표면적으로 맞아떨어졌다는 점이 함정이었다: 앱 on/off와 정확히
    연동되고, 어긋나는 양이 작고, 빠른 이동에서 눈에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
2026-09-04 release: 0.15.0 — 키 입력받기가 실제 키보드를 직접 읽는다
    단축키를 Qt 키 이벤트로 받고 있었다. Qt가 이 창에 넣어주는 것만 보이므로 데스크톱이
    먼저 가져가는 키는 애초에 도착하지 않는다 — super, alt+tab, print, 미디어키. 우분투
    설정의 단축키 지정이 키보드를 통째로 잡아서 이 문제를 푸는 것과 같은 방식으로,
    녹음기가 이미 읽던 입력 노드를 EVIOCGRAB으로 독점해서 읽는다.
    독점이 핵심이다. 데스크톱이 그 조합을 가져가지 않고, 지금 그 조합에 걸려 있는 동작도
    실행되지 않는다. 커널은 레이아웃 적용 전의 물리 키를 주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
2026-09-04 docs: 배포 바이너리에 들어가는 제3자 라이선스를 고지한다
    MIT는 macroKey가 직접 쓴 코드에만 해당한다. 릴리스에 올리는 실행 파일과 펌웨어
    이미지에는 LGPL로 배포되는 코드가 함께 들어가는데 — Qt/PySide6, pynput,
    Adafruit_NeoPixel, Arduino 코어 — 그 사실을 어디에도 적어두지 않았다. LGPL은
    고지와 교체 가능성 둘을 요구하므로 고지가 빠진 상태였다.
    THIRD_PARTY_NOTICES.md에 구성요소와 버전, 라이선스를 앱/펌웨어로 나눠 적고
    교체 방법을 밝힌다. 앱은 PyInstaller onefile이 Qt를 별도 .so/.dll로 풀어놓는
    동적 링크라 이미 충족하고, 펌웨어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
2026-09-04 docs: README를 릴리스 사용자 기준으로 다시 쓰고 문서를 Pages로 낸다
    README가 저장소 구조와 빌드 명령으로 시작해서, 릴리스를 받아 쓰는 사람이 정작
    필요한 것 — 무엇을 사서 어떻게 배선하는가 — 을 어디에서도 찾을 수 없었다.
    블로그 글도 같은 구멍이 있었다.
    - README를 ① 하드웨어 → ② 앱 받기 → ③ 펌웨어 순서로 바꾼다. 케이스(Stream
    Cheap, CC BY-SA), 준비물, 두 보드의 배선표, 배선 전에 알아야 할 함정 넷을
    넣는다. Pro Micro가 기본이고 RP2040은 용량 확장이라는 것을 표에 밝힌다.
    - 저장소 구조, venv 실행, build_release.sh,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
2026-09-04 docs: WS2812B 전압 서술을 보드별로 바로잡는다
    "3.3 V면 WS2812B가 제대로 켜지지 않는다"고 여러 곳에 적혀 있었는데, RP2040 판은
    3V3로 급전해도 동작한다. 규격(V_DD 3.5~5.3 V) 밖인 것은 맞고 5 V보다 어둡지만,
    "안 켜진다"는 사실과 다르다. 배선 가이드 07절은 이미 옳게 쓰여 있었고, 마크다운
    문서들만 "WS2812B 5V"로 뭉개져 있었다.
    - 급전 전압을 보드 로직 전압에 맞춘다는 원칙을 드러낸다. RP2040에서 모듈만 5 V에
    물리면 입력 하이 임계가 0.7 x V_DD = 3.50 V로 올라가 3.3 V 데이터로는 미달이고,
    아예 안 되는 것이 아니라 되다 안 되다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
2026-09-04 ci: 문서만 바뀐 push는 릴리스 빌드를 건너뛴다
    문서 한 줄을 고쳐도 Linux/Windows 바이너리와 두 보드의 펌웨어를 전부 다시 굽고
    `latest` 프리릴리스를 갱신하고 있었다. 결과물이 직전과 같은데 10분이 든다.
    트리거에 paths-ignore를 거는 흔한 방법은 쓰지 않는다. 태그 때문이다 — 이미 push된
    커밋에 태그만 붙이면 그 push에 담긴 커밋이 0개라 경로 필터가 아무것도 맞추지 못하고
    정식 릴리스가 통째로 스킵된다. 대신 gate 잡을 두고, 태그와 수동 실행은 무조건
    통과시킨 뒤 main push일 때만 바뀐 파일을 본다. 부모 커밋을 못 찾는 경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
2026-09-04 docs: 첫 플래싱이 두 보드 모두 수동인 것처럼 적혀 있던 것을 고친다
    Pro Micro는 꽂고 앱을 켜면 끝이다. 공장 상태로 스케치가 없으면 Caterina가 부트로더에
    그대로 앉아 있고, 스케치가 있어도 1200 bps 터치를 받아준다. enter_bootloader()도 그렇게
    동작한다 — 시리얼 포트가 잡히면 터치로 넣고, 포트가 아예 없을 때만
    NeedsManualBootloader를 던진다. RST-GND 더블탭은 첫 설치용이 아니라 USB가 죽은
    펌웨어에서 빠져나오는 복구용인데, 문서가 그 둘을 같은 것으로 적어 놨다.
    - README, BOARDS.md, promicro.md의 "첫 플래싱" 서술을 보드별로 가른다.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
2026-09-11 release: 0.16.1 — 실제 타이밍으로 키 홀드를 녹음·재생한다
2026-09-12 release: 0.17.0 — 녹음과 단축키를 한 번 눌러 여러 번 재생한다
    매크로 슬롯을 가리키는 키맵 항목의 비어 있던 `b` 바이트에 반복 횟수(1~255)를
    넣는다. EEPROM을 한 바이트도 더 쓰지 않고, 스키마도 그대로라 기존 매크로는
    전부 보존된다. `b`가 0인 기존 프로필은 1회로 읽힌다.
    0.16.1의 "실제 타이밍" 녹음을 쓸 수 있게 만드는 쪽에 가깝다. 10초 홀드가
    6 레코드이고 패드 전체가 308 레코드라, 같은 동작을 255번 반복하려고 255번
    녹음하는 것은 애초에 들어가지 않는다. 루프로는 6 레코드다.
    단축키는 4바이트가 전부 차 있어 횟수를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
2026-09-12 fix: Windows 자동 업데이트가 실행 중인 파일 위에 내려받던 것을 고친다
    릴리스를 받아 그대로 실행하면 이름이 `macrokey-windows-x86_64.exe`인데,
    `fetch_asset(release, name, current.parent)`가 같은 이름으로 같은 폴더에
    내려받았다. `into / name`이 곧 실행 중인 프로그램이라 교체 대상 위에 바로
    썼고, Windows는 실행 중인 .exe 쓰기를 막으므로 파일 이름을 직접 바꾸지 않은
    사람에게는 매번 실패했다. 다른 OS에서도 교체당할 바이너리가 내려받기의 임시
    공간을 겸했다.
    `fetch_asset`에 `filename`을 받아 옆에 `.<이름>.new`로 staging한다. 검증된
    새 파일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
    [app.py, logging_setup.py, test_update.py, translations.py]
2026-09-12 release: 0.18.0 — 긴 매크로를 멈추고, 홀드를 연타로 녹음하지 않는다
    실물 패드에서 나온 두 가지다. 39초짜리 녹음을 반복 1회로 걸어 둔 키는 케이블을
    뽑기 전에는 멈출 방법이 없었고, `w` 한 번 홀드는 press 레코드 190개로 녹음돼
    있었다.
    **중단 무장을 반복 횟수에서 경과 시간으로 옮긴다.** 0.17.0은 `loops > 1`에만
    중단을 열었는데, 그 근거("짧은 매크로 연타를 두 번째 탭이 죽이면 안 된다")가
    말하는 것은 패스 수가 아니라 길이다. 실제 홀드 타이밍이 든 녹음은 1회 재생도
    루프만큼 길다. 이제 `MK_MACRO_ABORT_ARM_MS`(1초)를 버티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
2026-09-13 chore: 기여에 CLA를 요구하고, README 버전을 테스트가 지키게 한다
    **CLA.** 기여물의 저작권은 기여자에게 남으므로, 서명을 받아 두지 않으면 나중에
    라이선스를 바꾸거나 상업 라이선스를 따로 내주는 일이 불가능해진다. 기여자 한 명만
    연락이 끊겨도 막히고 소급해서 받을 수 없다 — 판매를 시작하기 전, 그리고 외부 PR이
    들어오기 전에 걸어 두는 이유가 그것이다.
    양도가 아니라 라이선스다. 기여자는 저작권을 그대로 갖고 다른 곳에 다른 조건으로
    쓸 자유도 유지한다. 받는 것은 현재 저장소 라이선스가 아닌 조건으로도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
2026-09-15 Fix recorded key hold timing and input event ordering
    [test_evdev_source.py, test_key_hold_recording.py]
